caiespin/Master_Tesis_2DOF_Gimbal_Model_and_Control/README.md

# Master_Tesis_2DOF_Gimbal_Model_and_Control
Modelling and control of a two axis camera Pan-Tilt unit (gimbal)

Check results at [video](https://youtu.be/UOXjcZ1aPac)

**Simulations**

To visualize the simulation graphs:

1. Run GimbalParameters.m
2. Run each model ControlCSM.slx, ControlCSMSW.slx, ControlPI.slx and ControlSM.slx
3. Run GenerateGraphs.m

**dsPIC Implementation**

Needed MPLAB Device Blocks for Simulink

**LaTex Document**

Thesis Document
