caiespin/Master_Tesis_2DOF_Gimbal_Model_and_Control/LaTex_Doc/includes/portada1.tex

\thispagestyle{empty}
\begin{minipage}{0.15\textwidth}

\end{minipage}
\begin{minipage}{0.87\textwidth}
\begin{center}
\sc CENTRO DE INVESTIGACI\'{O}N Y DE ESTUDIOS \\ AVANZADOS DEL INSTITUTO POLIT\'{E}CNICO NACIONAL
\end{center}
\end{minipage}
\begin{minipage}{1\textwidth}
\vspace{0.2cm}
\centerline{\Large \bf Unidad Zacatenco}
\vspace{0.25cm}
\centerline{\bf Programa de}
\vspace{0.20cm}
\centerline{\large \bf Sistemas Aut\'onomos de Navegaci\'on A\'erea y Submarina}
\vspace{0.8cm}
\centerline{\Large \bf "Dise\~no e Implementaci\'on del Control }
\vspace{0.5cm}
\centerline{\Large \bf de un Gimbal de Dos Grados de Libertad"}
\vspace{0.8cm}
\centerline{\Large \bf TESIS}
\vspace{0.5cm}
\centerline{\bf Que presenta}
\vspace{0.4cm}
\centerline{\Large \bf Carlos Isaac Espinosa Ram\'irez}
\vspace{0.4cm}
\centerline{\bf Para obtener el grado de }
\vspace{0.4cm}
\centerline{\Large \bf Maestro en Ciencias}
\vspace{0.4cm}
\centerline{\bf En}
\vspace{0.4cm}
\centerline{\Large \bf Sistemas Aut\'onomos de Navegaci\'on A\'erea y Submarina}
\vspace{0.6cm}
\centerline{\bf Director de la Tesis:}
\vspace{0.20cm}
\centerline{\Large \bf Dr. Rogelio Lozano Leal}

\vspace{0.6cm}
{\large \bf M\'{e}xico, D.F.\ \hfill Enero, 2016}
\end{minipage}%
%EndExpansion

%\pagebreak
%TCIMACRO{\TeXButton{Pagina en Blanco}{\thispagestyle{empty}}}%
%BeginExpansion
\newpage
\thispagestyle{empty}%
%EndExpansion
