caiespin/Master_Tesis_2DOF_Gimbal_Model_and_Control/LaTex_Doc/img/temp/ArrMotor.docx

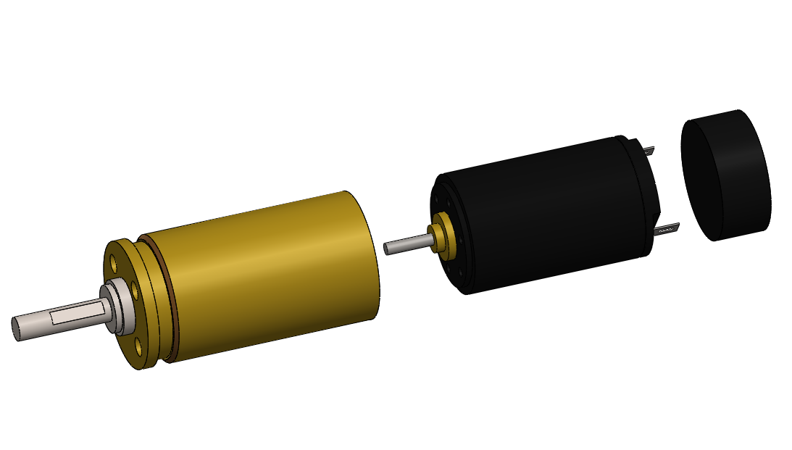
[picture p11: figure]

Encoder

Motor

Moto-reductor
