caiespin/Master_Tesis_2DOF_Gimbal_Model_and_Control/LaTex_Doc/img/temp/BaseGimbal.docx

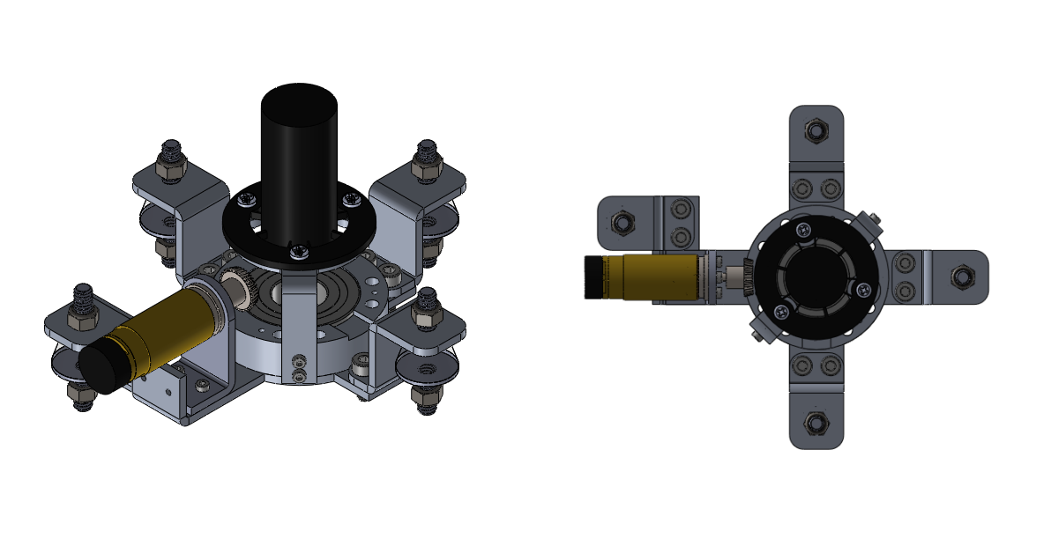
[picture p12: figure]

Piñón de

Transmisión

Motor

Balero

Slip Ring

Amortiguadores Vibratorios
