caiespin/Master_Tesis_2DOF_Gimbal_Model_and_Control/LaTex_Doc/img/temp/BaseTilt.docx

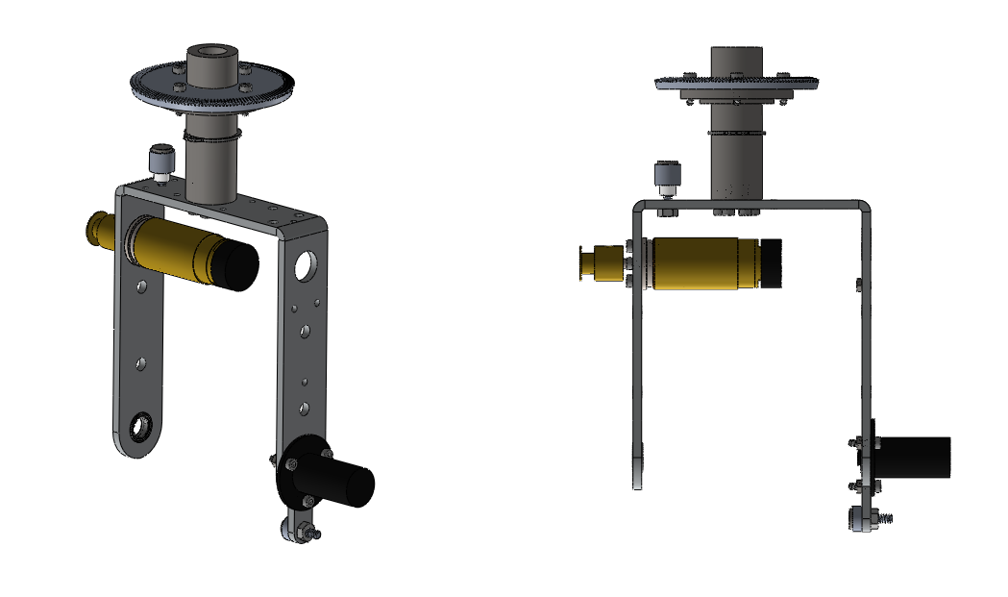
[picture p13: figure]

Polea de

Transmisión

Actuador

Magnético

Eje

Actuador

Magnético

Corona de

Transmisión

Motor

Slip Ring

Balero
