caiespin/Master_Tesis_2DOF_Gimbal_Model_and_Control/LaTex_Doc/img/temp/Gimbalclases.docx

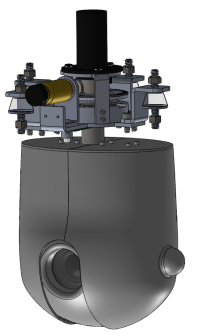
[picture p14: figure]
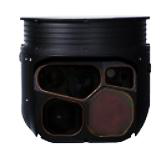
[picture p15: figure]
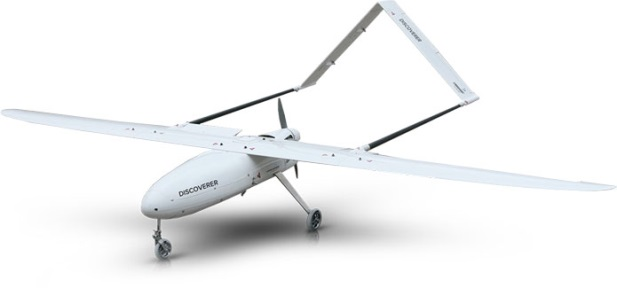
[picture p16: figure]
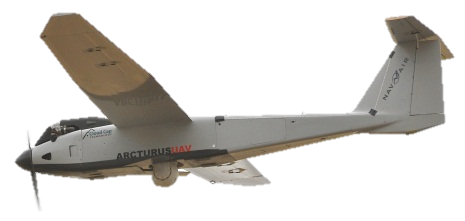
[picture p17: figure]
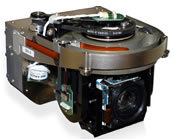
[picture p18: figure]

Plataforma de tesis

Cloud Cap: TASE 150

FLIR: Star SAFIRE 380

Cloud Cap: TASE 500

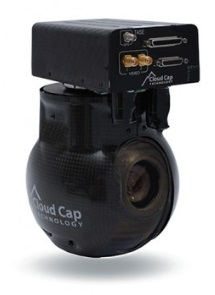
[picture p19: figure]
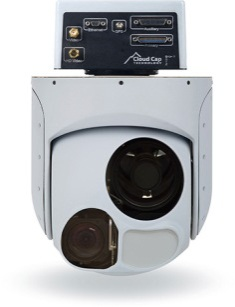
[picture p20: figure]

Cloud Cap: TASE 150

~1 kg

> 25 kg

5 kg – 10kg

< 0.5 kg

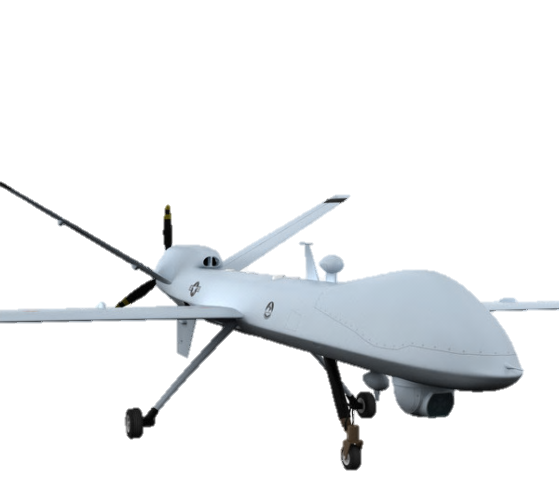
[picture p21: figure]
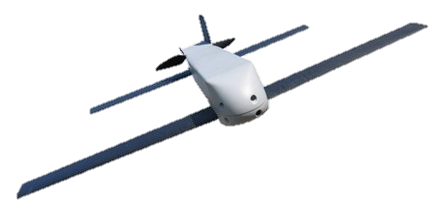
[picture p22: figure]
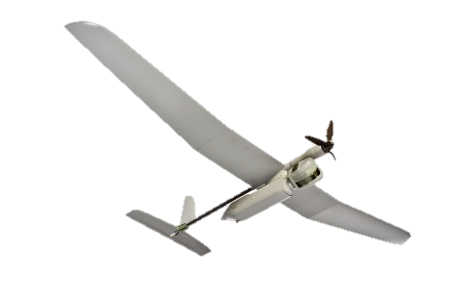
[picture p23: figure]
