caiespin/Master_Tesis_2DOF_Gimbal_Model_and_Control/LaTex_Doc/img/temp/LOSDef.docx

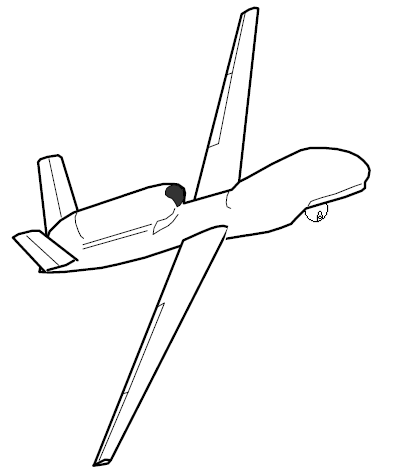
[picture p24: figure]

Error

Línea de Vista Ideal

Objetivo

Línea de Vista

Sensor

Campo de Visión (FOV)
