caiespin/Master_Tesis_2DOF_Gimbal_Model_and_Control/LaTex_Doc/img/ArrMotor.pdf

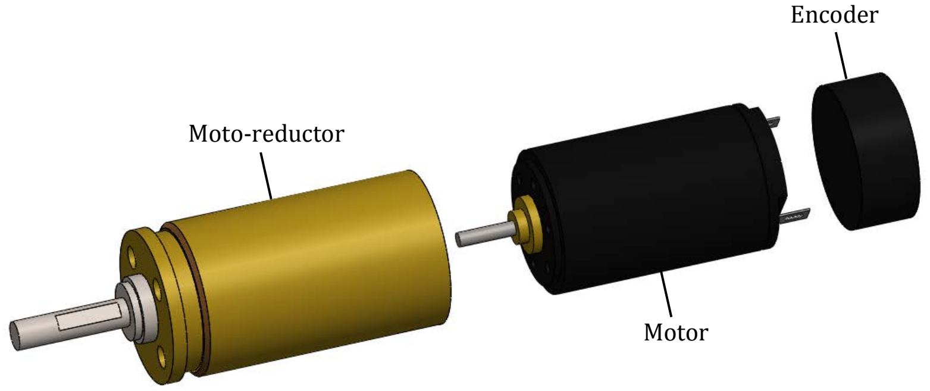
[picture p25: page 1]

Moto-reductor

Motor

Encoder
