caiespin/Master_Tesis_2DOF_Gimbal_Model_and_Control/LaTex_Doc/img/BasePan.pdf

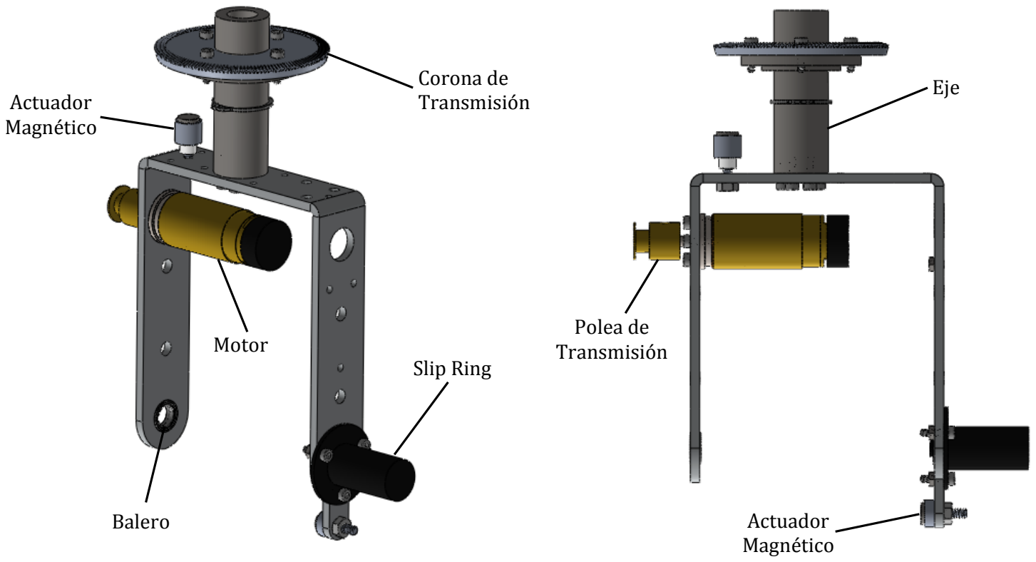
[picture p26: page 1]

Balero

Slip Ring

Motor

Corona de
Actuador Transmisión
Magnético
Polea de
Transmisión

Eje

Actuador
Magnético
