caiespin/Master_Tesis_2DOF_Gimbal_Model_and_Control/LaTex_Doc/img/Gimbalclases1.pdf

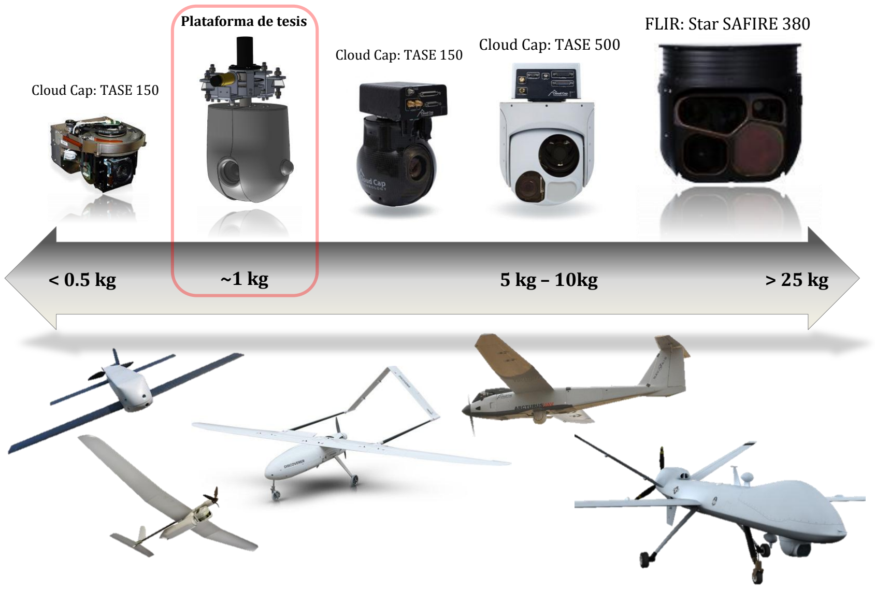
[picture p27: page 1]

### FLIR: Star SAFIRE 380

Cloud Cap: TASE 500
Cloud Cap: TASE 150

Cloud Cap: TASE 150

< 0.5 kg | 5 kg – 10kg | > 25 kg

Plataforma de tesis

~1 kg
