caiespin/Master_Tesis_2DOF_Gimbal_Model_and_Control/LaTex_Doc/img/LOSDef.pdf

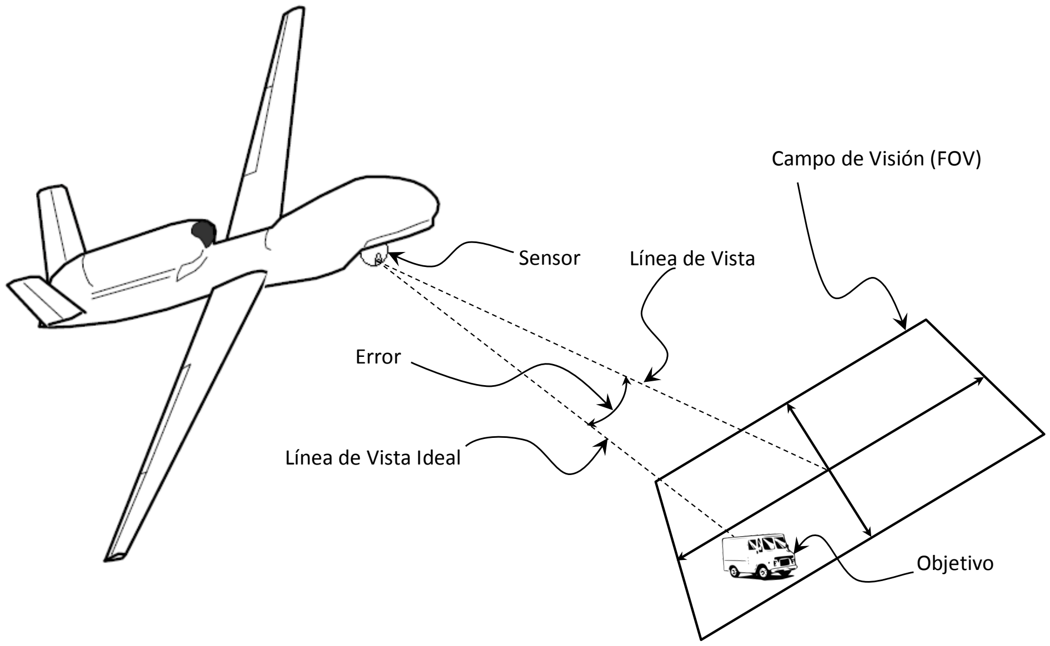
[picture p28: page 1]

Campo de Visión (FOV)

Sensor Línea de Vista

Objetivo

Línea de Vista Ideal

Error
