caiespin/Master_Tesis_2DOF_Gimbal_Model_and_Control/LaTex_Doc/includes/contents.tex

%%%%%%%%%%%%%%%%%%%%%%%%%%%%%%%%%%%%%%%%%%%%%%%%%%%%%%%%%%%%%%%%%%%%%%%%%%%%%%%%%%%%%%%%%%%%%%
% Plantilla para tesis por David Luna se encuentra bajo una Licencia
% Creative Commons Atribución-NoComercial-CompartirIgual 3.0 Unported.
% http://creativecommons.org/licenses/by-nc-sa/3.0/
%%%%%%%%%%%%%%%%%%%%%%%%%%%%%%%%%%%%%%%%%%%%%%%%%%%%%%%%%%%%%%%%%%%%%%%%%%%%%%%%%%%%%%%%%%%%%%

\cleardoublepage
\tableofcontents
\cleardoublepage
%\addcontentsline{toc}{chapter}{Lista de figuras} % para que aparezca en el indice de contenidos
\listoffigures % indice de figuras

\cleardoublepage
%\addcontentsline{toc}{chapter}{Lista de tablas} % para que aparezca en el indice de contenidos
\listoftables % indice de tablas
\newpage
$\ $
\thispagestyle{empty} % para que no se numere esta pagina
