caiespin/Master_Tesis_2DOF_Gimbal_Model_and_Control/LaTex_Doc/includes/Dedicatoria.tex

\thispagestyle{empty}
\newenvironment{dedication} {\cleardoublepage
\thispagestyle{empty}
\vspace*{\stretch{1}} \begin{center} \em} {\end{center}
\vspace*{\stretch{3}} \clearpage}
\begin{dedication}
\hfill \
\parbox{12cm}{
\begin{verse}
A mis padres,\newline
por su amor y apoyo incondicional.
\end{verse}

\begin{verse}
A mis hermanas,\newline
por su cari\~{n}o y paciencia.
\end{verse}

\begin{verse}
A mi novia,\newline
por todos los retos que superamos juntos.
\end{verse}
}
\end{dedication}

\newpage
$\ $
\thispagestyle{empty} % para que no se numere esta pagina
