caiespin/Master_Tesis_2DOF_Gimbal_Model_and_Control/LaTex_Doc/includes/publicaciones.tex

%%%%%%%%%%%%%%%%%%%%%%%%%%%%%%%%%%%%%%%%%%%%%%%%%%%%%%%%%%%%%%%%%%%%%%%%%%%%%%%%%%%%%%%%%%%%%%
% Plantilla para tesis por David Luna se encuentra bajo una Licencia
% Creative Commons Atribución-NoComercial-CompartirIgual 3.0 Unported.
% http://creativecommons.org/licenses/by-nc-sa/3.0/
%%%%%%%%%%%%%%%%%%%%%%%%%%%%%%%%%%%%%%%%%%%%%%%%%%%%%%%%%%%%%%%%%%%%%%%%%%%%%%%%%%%%%%%%%%%%%%

%\addcontentsline{toc}{chapter}{Agradecimientos}

\begin{center}
\textbf{\large AGRADECIMIENTOS}
\end{center}

\vspace{1.5cm}

Agradezco a el CONACYT por el apoyo econ\'{o}mico brindado para la realizaci\'{o}n de mis estudios de maestr\'{i}a.
\newline\newline
Agradezco al CINVESTAV y al laboratorio UMI LAFMIA por la oportunidad de realizar mis estudios de posgrado en esta intituci\'{o}n de enorme calidad.
\newline\newline
Quiero agradecerle a mi asesor, el Dr. Rogelio Lozano leal y 
\newline\newline
Agradezco a los miembros del jurado, el Dr. Sergio Rosario Salazar Cruz, el Dr. Antonio Osorio Cordero y al Dr. Mois\'{e}s Bonilla Estrada, por las valiosas contribuciones que hicieron al trabajo final y por el tiempo que dedicaron para revisarlo, a\'{u}n a pesar de las tantas actividades que los ocupan.
\newline\newline
Agradezco al INIDETAM y a su personal por el  valioso apoyo en la realizaci\'{o}n de este proyecto   y especialmente al Dr. Mariano I. Lizarraga Fernandez por su gu\'{i}a y conocimientos invaluables que me brindo para llevar a cabo esta investigaci\'{o}n.
\newline\newline
Finalmente agradezco a los excelentes profesores del programa de maestr\'{i}a que hacen posible el conocimiento en las aulas. A mis compa\~{n}eros de la generaci\'{o}n, por todos los buenos momentos que viv\'{i} con ellos.
\newline\newline

\hfill
\newpage
$\ $
\thispagestyle{empty} % para que no se numere esta pagina
