caiespin/Master_Tesis_2DOF_Gimbal_Model_and_Control/LaTex_Doc/includes/resumen.tex

%%%%%%%%%%%%%%%%%%%%%%%%%%%%%%%%%%%%%%%%%%%%%%%%%%%%%%%%%%%%%%%%%%%%%%%%%%%%%%%%%%%%%%%%%%%%%%
% Plantilla para tesis por David Luna se encuentra bajo una Licencia
% Creative Commons Atribución-NoComercial-CompartirIgual 3.0 Unported.
% http://creativecommons.org/licenses/by-nc-sa/3.0/
%%%%%%%%%%%%%%%%%%%%%%%%%%%%%%%%%%%%%%%%%%%%%%%%%%%%%%%%%%%%%%%%%%%%%%%%%%%%%%%%%%%%%%%%%%%%%%

%\addcontentsline{toc}{chapter}{Resumen}
\begin{center}
\textbf{\large RESUMEN}
\end{center}

\vspace{3cm}

Esta tesis trata sobre el modelado, control y desarrollo de una unidad de cámara Pan-Tilt (gimbal) de 2 grados de libertad el cual esta destinado a usarse en un avión no tripulado (UAV) para fines de inteligencia, vigilancia y reconocimiento. El objetivo de esta tesis es desarrollar una estructura de control que permita estabilizar el eje óptico de la cámara hacia un objetivo aislando la cámara de las perturbaciones del entorno de operación, tales como torques externos y el movimiento angular de la plataforma logrando así mantener su dirección en el espacio inercial.\\

Se desarrollan las ecuaciones de movimiento del gimbal por el método de Newton-Euler y se formulan para poder interpretar las propiedades del sistema. Con ayuda de software CAD se obtiene una aproximación de los parámetros inerciales y se realizan diferentes simulaciones. Se procede a la construcción del prototipo y la programación del micro controlador utilizado. Finalmente se realizan pruebas para la obtención y verificación de resultados.\\

\newpage
$\ $
\thispagestyle{empty} % para que no se numere esta pagina
