caiespin/Master_Tesis_2DOF_Gimbal_Model_and_Control/LaTex_Doc/img/VN100Responce.docx

Ejemplo de comando de solicitud:

$VNRRG,8*4B

Ejemplo de respuesta del VN-100:

$VNRRG,08,-114.314,+000.058,-001.773*5F
