caiespin/Master_Tesis_2DOF_Gimbal_Model_and_Control/LaTex_Doc/img/temp/BaseTilt1.docx

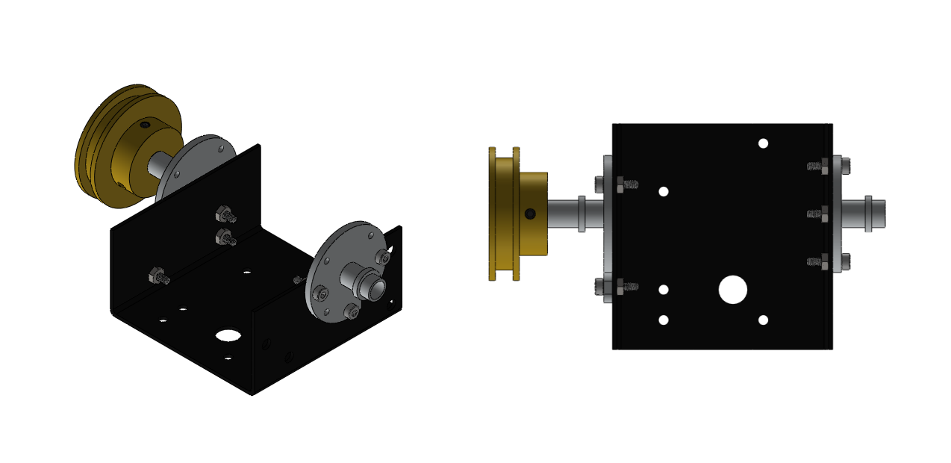
[picture p30: figure]

Polea de

Transmisión

Eje

Eje

Soporte de

la Cámara
