caiespin/Master_Tesis_2DOF_Gimbal_Model_and_Control/LaTex_Doc/img/temp/Gimbal_Frames.docx

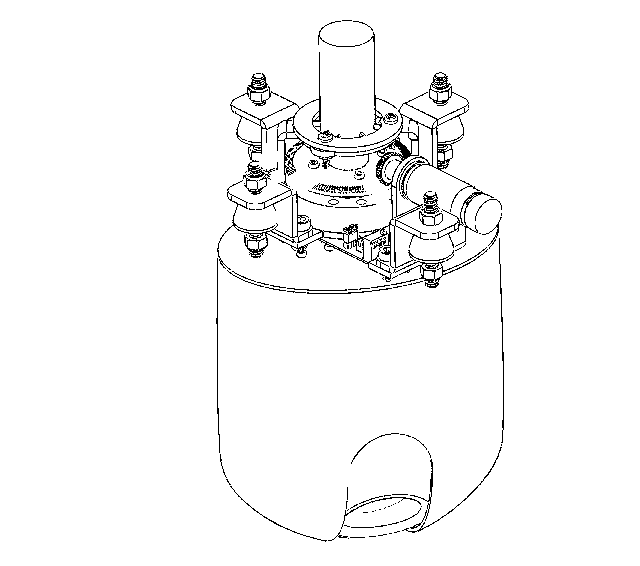
[picture p31: figure]

Marco del Eslabón Interno (T)

Eje de

Elevación cruzada

(Pan)

Eje de Elevación

(Tilt)

Marco del Cuerpo

(B)

Marco de Eslabón Externo (P)

η

i_T (Line-Of-Sight)

i_E

k_E

j_E

Marco Inercial

(E)

η

ε

j_B

ε

k_B , k_P

k_T

i_P

j_P

i_P

j_P , j_T

i_B
