caiespin/Master_Tesis_2DOF_Gimbal_Model_and_Control/LaTex_Doc/img/temp/integration.docx

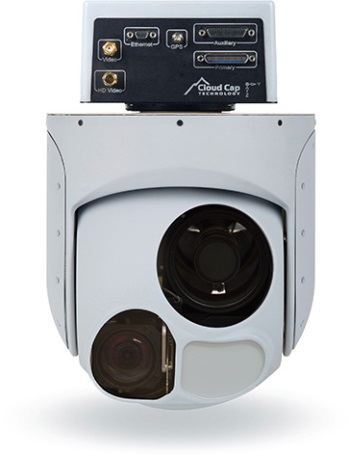
[picture p33: figure]
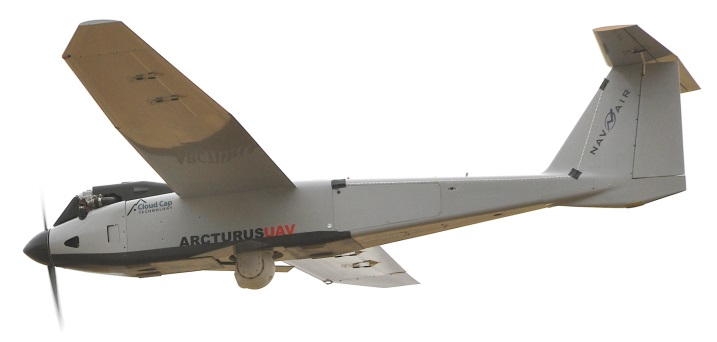
[picture p34: figure]
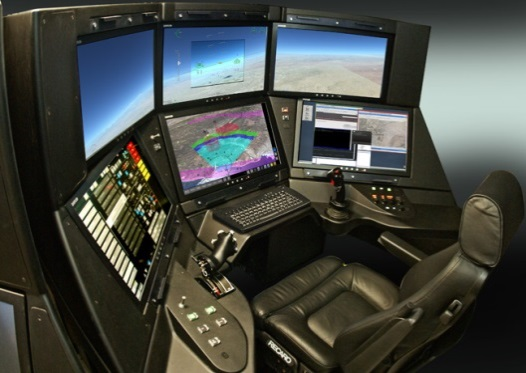
[picture p35: figure]

Plataforma Gimbal

Aviónica del vehículo

Estación de control en tierra

Conexión de

Radiofrecuencia

Bus CAN
