caiespin/Master_Tesis_2DOF_Gimbal_Model_and_Control/LaTex_Doc/img/temp/Limit.docx

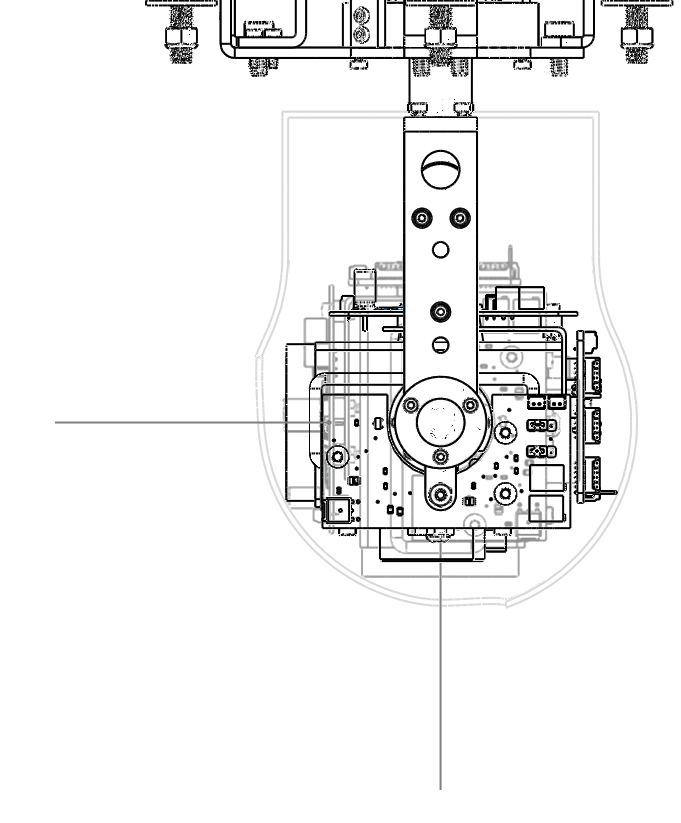
[picture p36: figure]

90°
