caiespin/Master_Tesis_2DOF_Gimbal_Model_and_Control/LaTex_Doc/img/temp/Untitled.docx

Platform Rotation Angle Example

Longitudinal Axis

North

Arbitrary Platform Orientation

Platform Aligned to North-East-Down

East

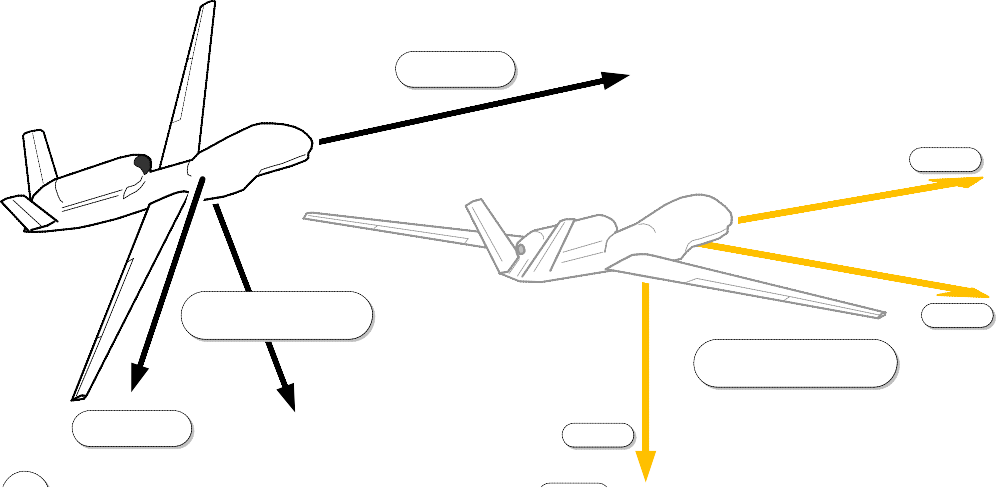
[picture p37: figure]

Transverse Axis

Down
