caiespin/Master_Tesis_2DOF_Gimbal_Model_and_Control/LaTex_Doc/img/BaseTilt.pdf

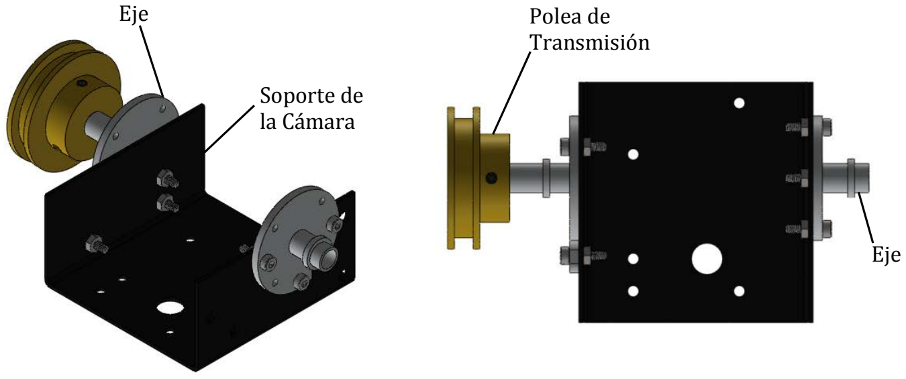
[picture p38: page 1]

Polea de
Transmisión
Soporte de la Cámara

Eje

Eje
