caiespin/Master_Tesis_2DOF_Gimbal_Model_and_Control/LaTex_Doc/img/CamaraGiroEstabilizada3-eps-converted-to.pdf

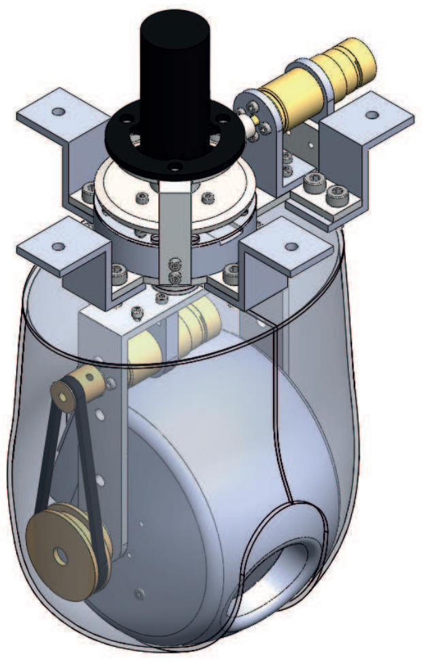
[picture p39: page 1]
