caiespin/Master_Tesis_2DOF_Gimbal_Model_and_Control/LaTex_Doc/img/document1.pdf

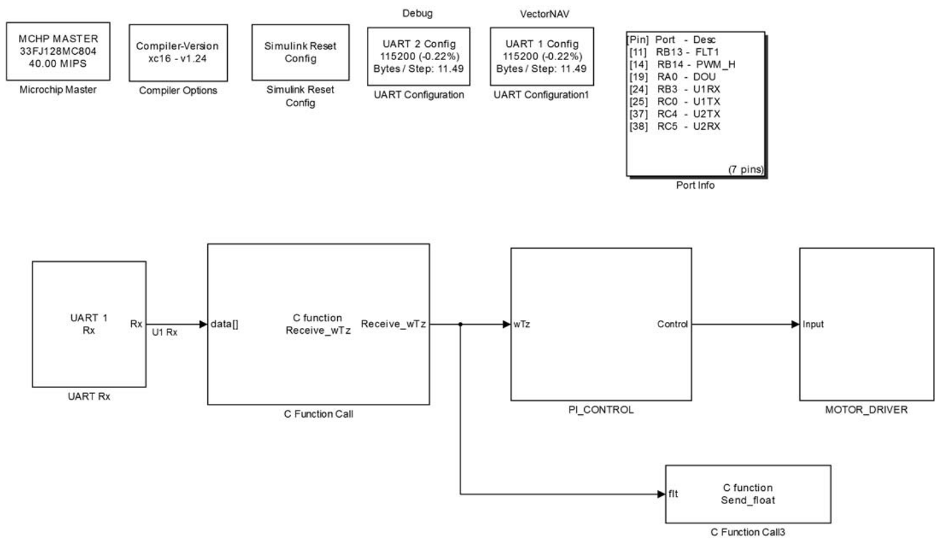
[picture p40: page 1]
