caiespin/Master_Tesis_2DOF_Gimbal_Model_and_Control/LaTex_Doc/img/Gimbalclases.pdf

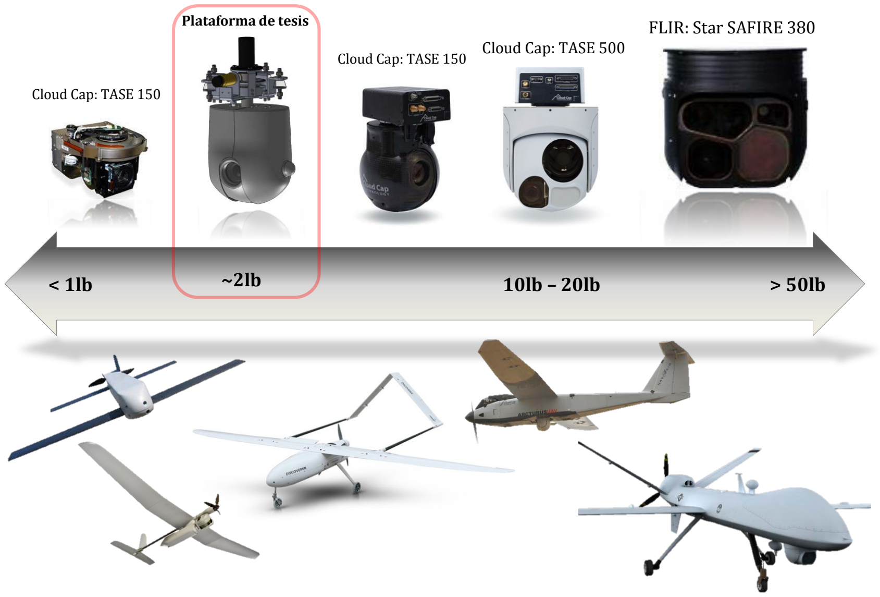
[picture p41: page 1]

FLIR: Star SAFIRE 380
Cloud Cap: TASE 500 Cloud Cap: TASE 150 Cloud Cap: TASE 150
< 1lb | 10lb – 20lb | > 50lb

Plataforma de tesis

~2lb
