caiespin/Master_Tesis_2DOF_Gimbal_Model_and_Control/LaTex_Doc/img/GimbalModelSimulink.pdf

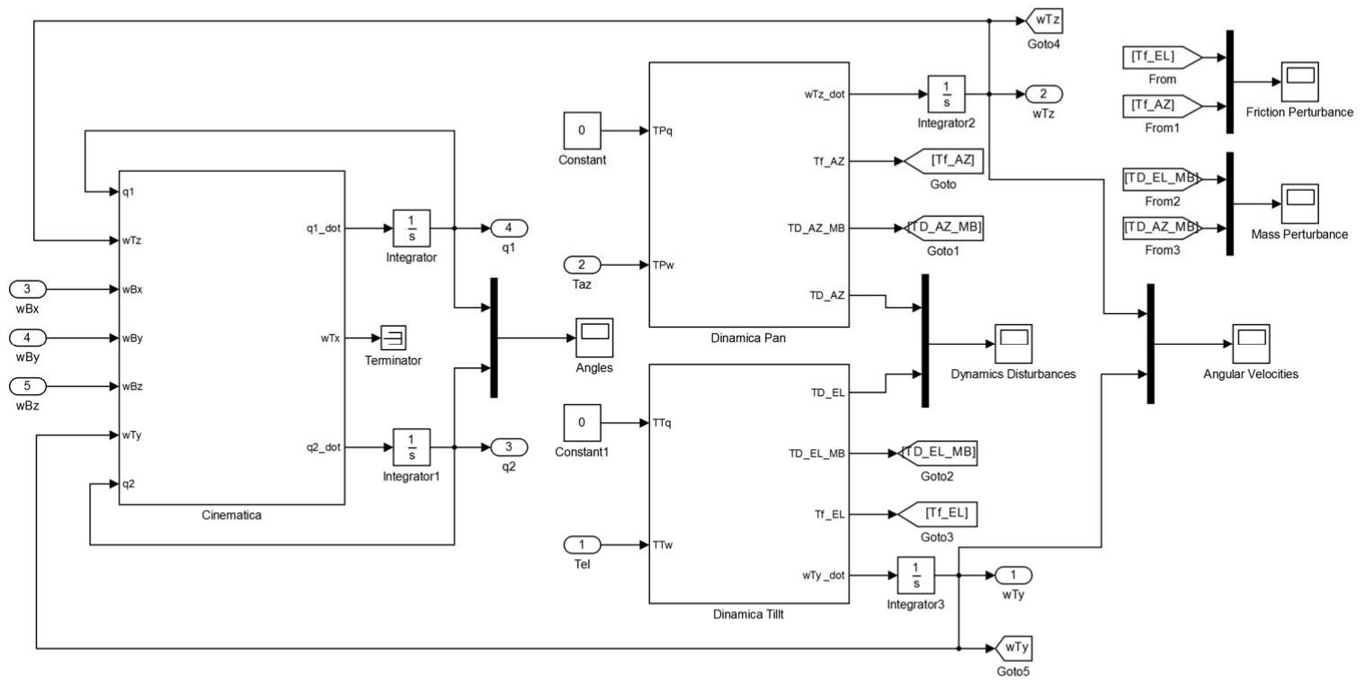
[picture p42: page 1]
