caiespin/Master_Tesis_2DOF_Gimbal_Model_and_Control/LaTex_Doc/img/HomePos.pdf

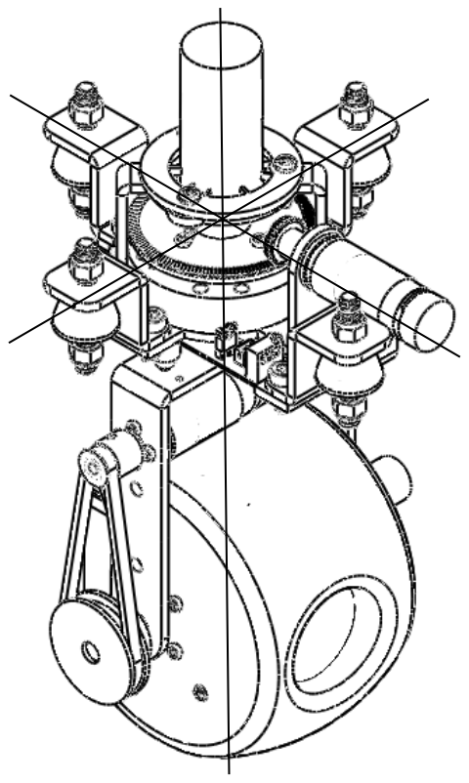
[picture p43: page 1]
