caiespin/Master_Tesis_2DOF_Gimbal_Model_and_Control/LaTex_Doc/img/integration.pdf

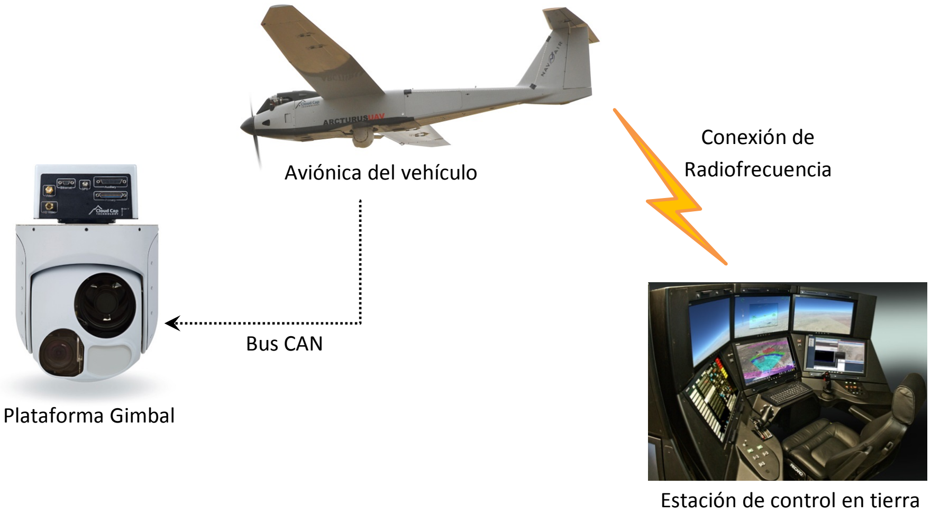
[picture p44: page 1]

Bus CAN

Conexión de
Radiofrecuencia

Estación de control en tierra

Aviónica del vehículo

Plataforma Gimbal
