caiespin/Master_Tesis_2DOF_Gimbal_Model_and_Control/LaTex_Doc/img/Limit.pdf

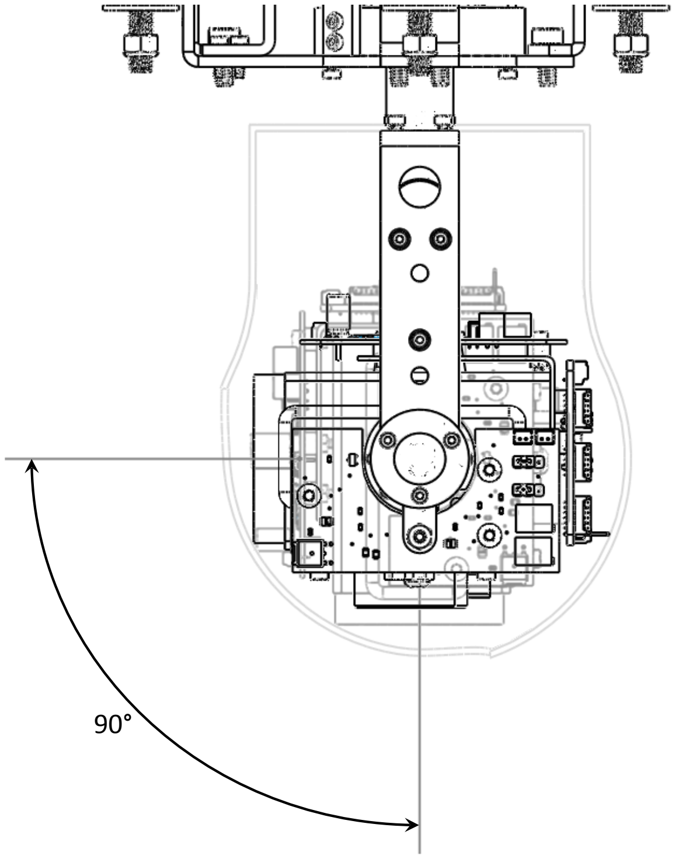
[picture p45: page 1]

90°
