caiespin/Master_Tesis_2DOF_Gimbal_Model_and_Control/LaTex_Doc/img/Prog.pdf

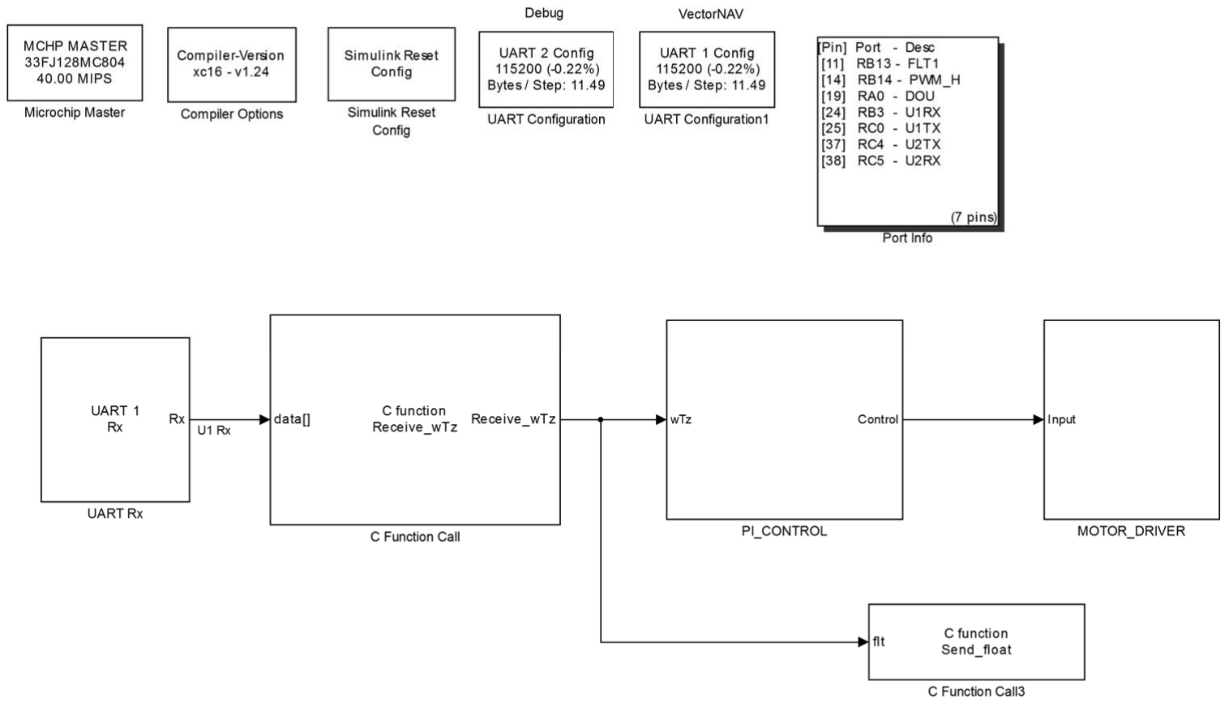
[picture p46: page 1]
