caiespin/Master_Tesis_2DOF_Gimbal_Model_and_Control/LaTex_Doc/img/Simulink.pdf

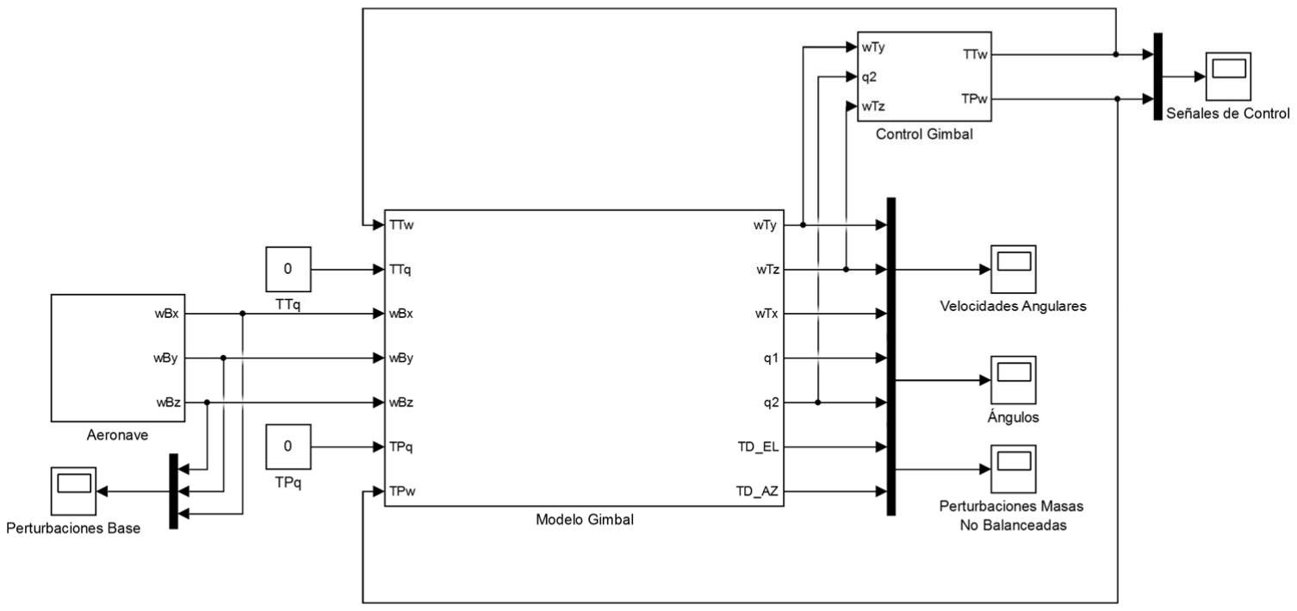
[picture p47: page 1]
