caiespin/Master_Tesis_2DOF_Gimbal_Model_and_Control/LaTex_Doc/img/15-5_P.JPG

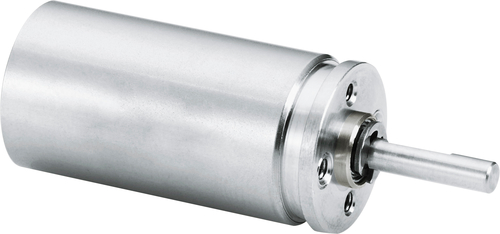
LaTex_Doc/img/15-5_P.JPG
