caiespin/Master_Tesis_2DOF_Gimbal_Model_and_Control/LaTex_Doc/img/GimbalLimit.PNG

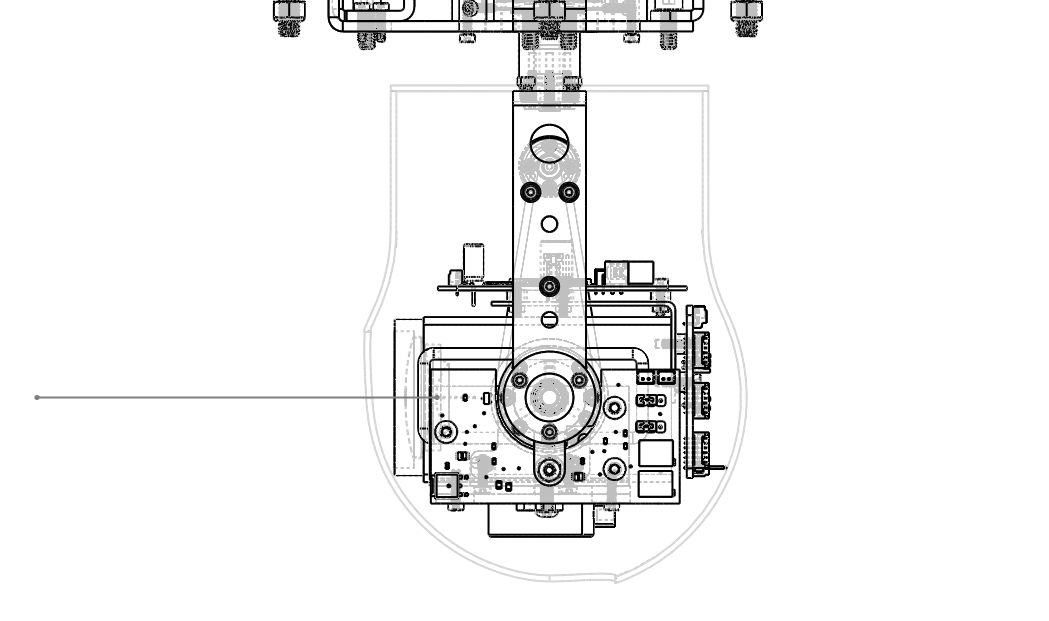
LaTex_Doc/img/GimbalLimit.PNG
