caiespin/Master_Tesis_2DOF_Gimbal_Model_and_Control/LaTex_Doc/img/temp/635797445127078483-MQ9-Reaper.JPG

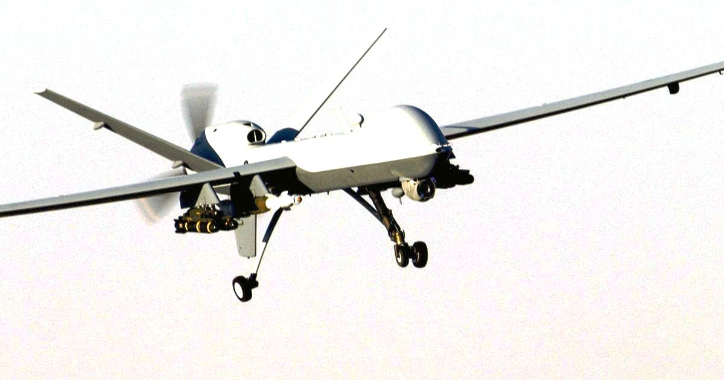
LaTex_Doc/img/temp/635797445127078483-MQ9-Reaper.JPG
