caiespin/Master_Tesis_2DOF_Gimbal_Model_and_Control/LaTex_Doc/img/temp/AIR_UAV_Skylark-ILE_Block_2_Elbit_lg.jpg

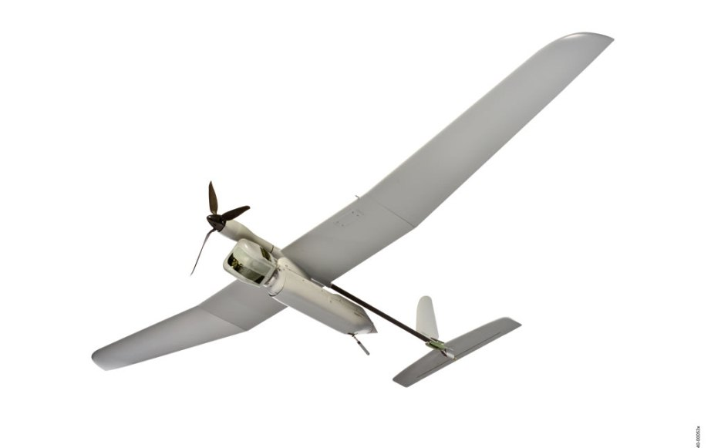
LaTex_Doc/img/temp/AIR_UAV_Skylark-ILE_Block_2_Elbit_lg.jpg
