caiespin/Master_Tesis_2DOF_Gimbal_Model_and_Control/LaTex_Doc/img/temp/design/GimbalBase1.PNG

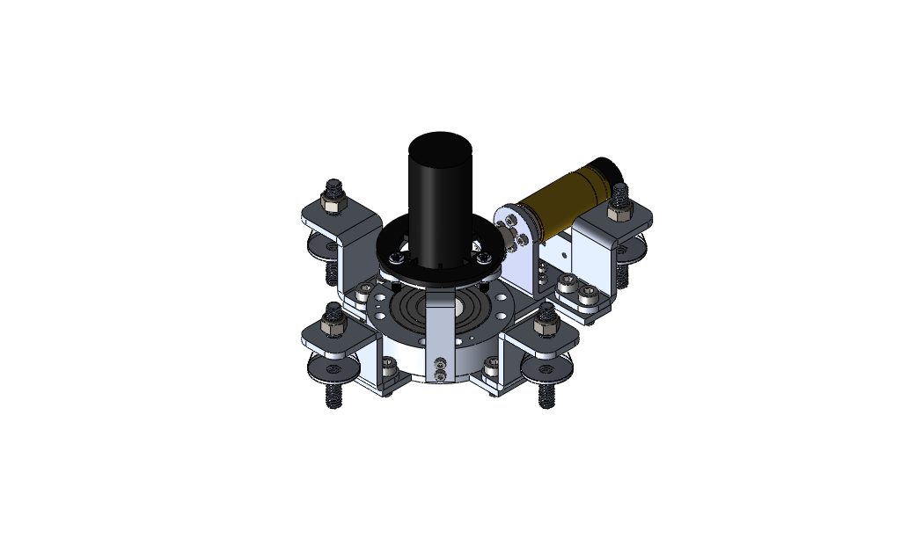
LaTex_Doc/img/temp/design/GimbalBase1.PNG
