caiespin/Master_Tesis_2DOF_Gimbal_Model_and_Control/LaTex_Doc/img/temp/gimbal_tase_lt_rev-250x250.jpg

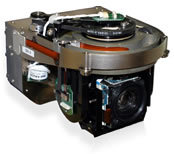
LaTex_Doc/img/temp/gimbal_tase_lt_rev-250x250.jpg
