caiespin/Master_Tesis_2DOF_Gimbal_Model_and_Control/LaTex_Doc/img/temp/MQ_9_Reaper_V2_08.jpg51b3aa70-9075-4628-b7ff-b451863145acLarge.jpg

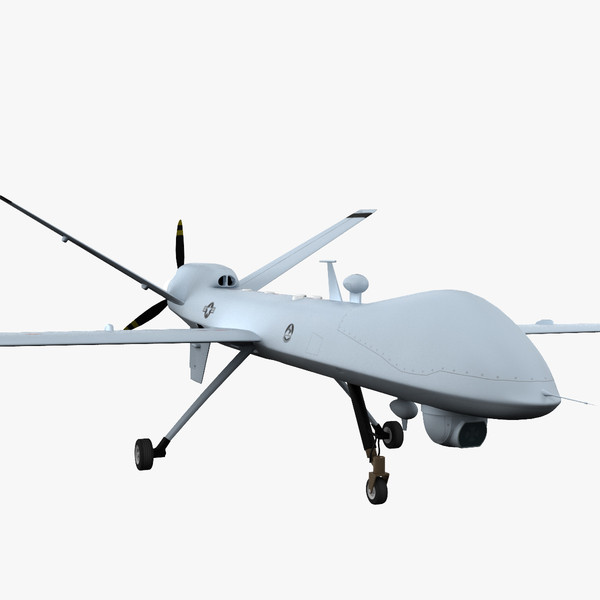
LaTex_Doc/img/temp/MQ_9_Reaper_V2_08.jpg51b3aa70-9075-4628-b7ff-b451863145acLarge.jpg
