caiespin/Master_Tesis_2DOF_Gimbal_Model_and_Control/LaTex_Doc/img/temp/puma_ae_civil.jpg

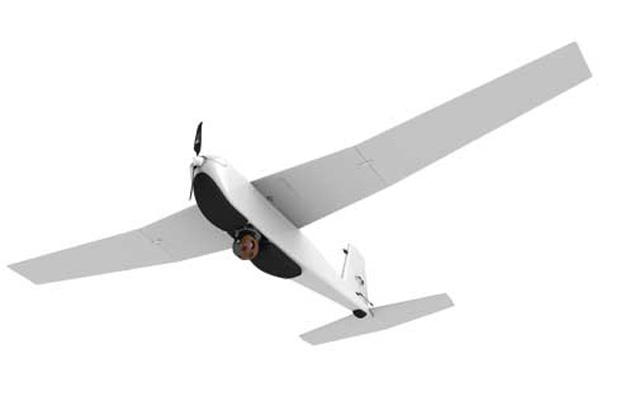
LaTex_Doc/img/temp/puma_ae_civil.jpg
