caiespin/Master_Tesis_2DOF_Gimbal_Model_and_Control/LaTex_Doc/img/temp/shark1.jpg

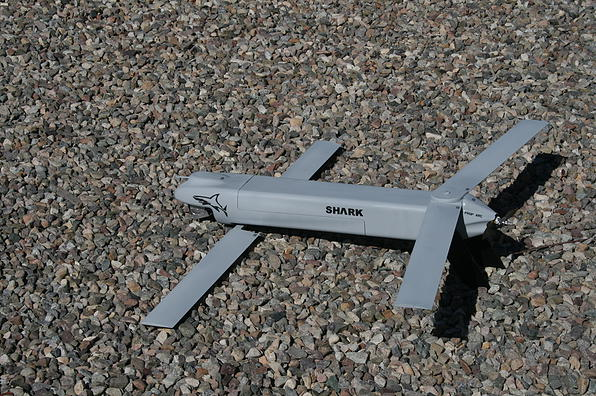
LaTex_Doc/img/temp/shark1.jpg
