caiespin/Master_Tesis_2DOF_Gimbal_Model_and_Control/LaTex_Doc/img/temp/TASE500-360-animation-01.png

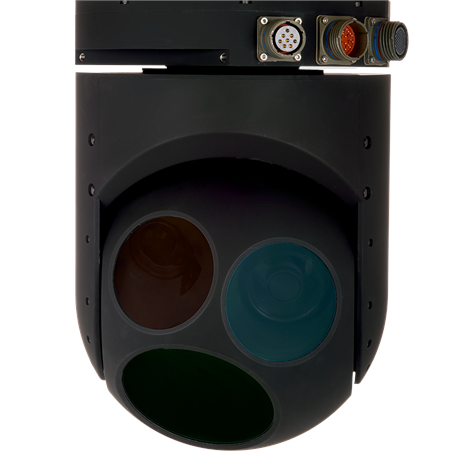
LaTex_Doc/img/temp/TASE500-360-animation-01.png
