caiespin/Master_Tesis_2DOF_Gimbal_Model_and_Control/LaTex_Doc/img/TransmisionPan.jpg

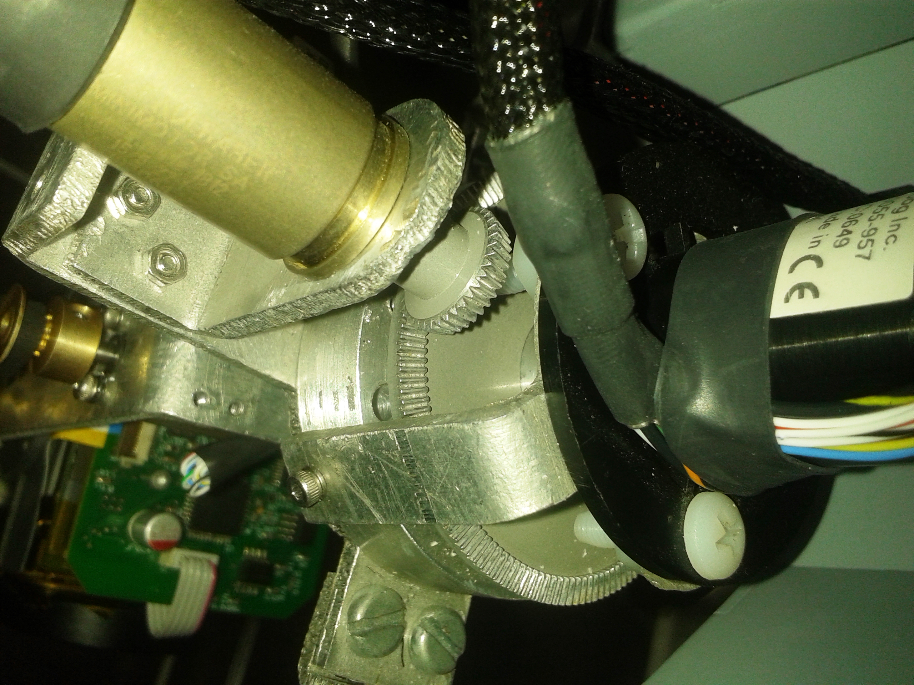
LaTex_Doc/img/TransmisionPan.jpg
