caiespin/Master_Tesis_2DOF_Gimbal_Model_and_Control/LaTex_Doc/img/temp/GimbalParts.docx

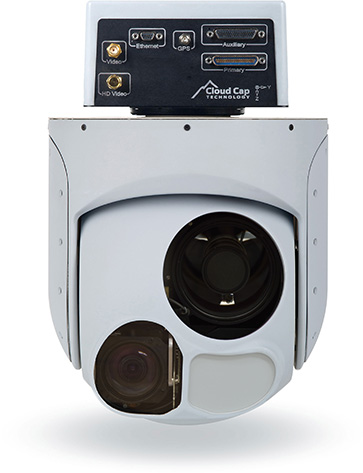
[picture p91: figure]

Base o Montaje

Eslabón externo

(Pan)

Eslabón interno (Tilt)
