caiespin/Master_Tesis_2DOF_Gimbal_Model_and_Control/LaTex_Doc/img/BasePerturbance-eps-converted-to.pdf

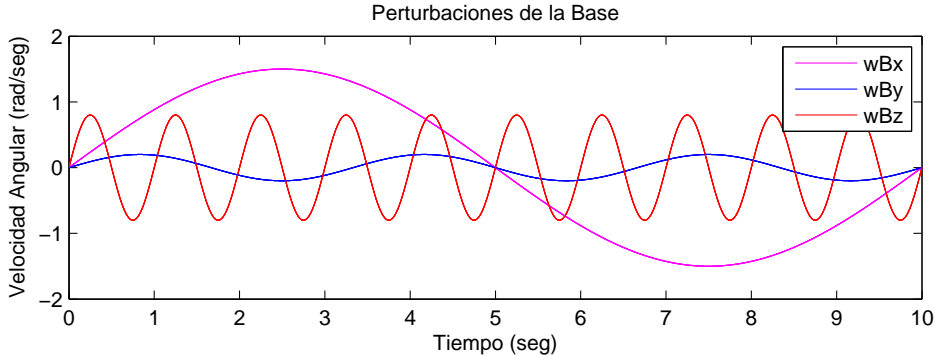
[picture p92: page 1]
Tiempo (seg); wBx wBy wBz

Perturbaciones de la Base

Velocidad Angular (rad/seg)
