caiespin/Master_Tesis_2DOF_Gimbal_Model_and_Control/LaTex_Doc/img/ChattCont-eps-converted-to.pdf

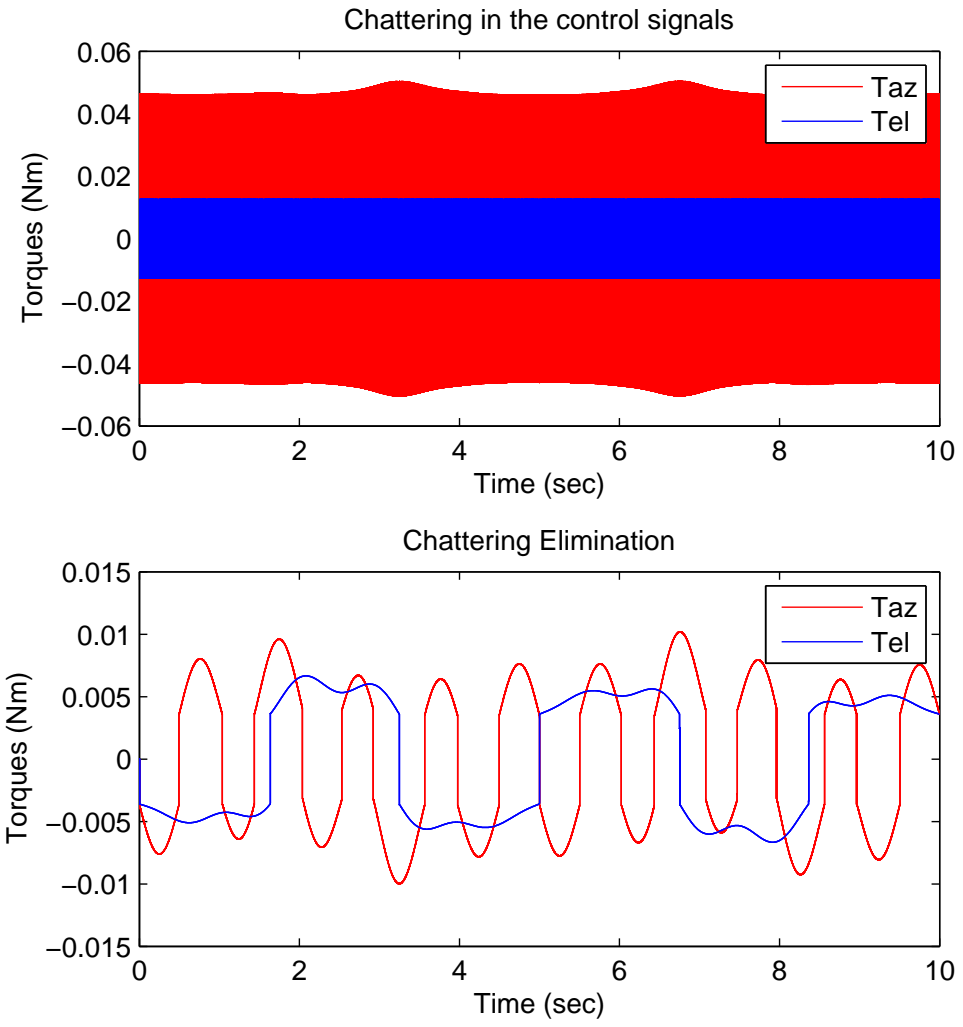
[picture p93: page 1]
Time (sec); Torques (Nm); Chattering Elimination; Taz Tel

Chattering in the control signals
