caiespin/Master_Tesis_2DOF_Gimbal_Model_and_Control/LaTex_Doc/img/ControlAction-eps-converted-to.pdf

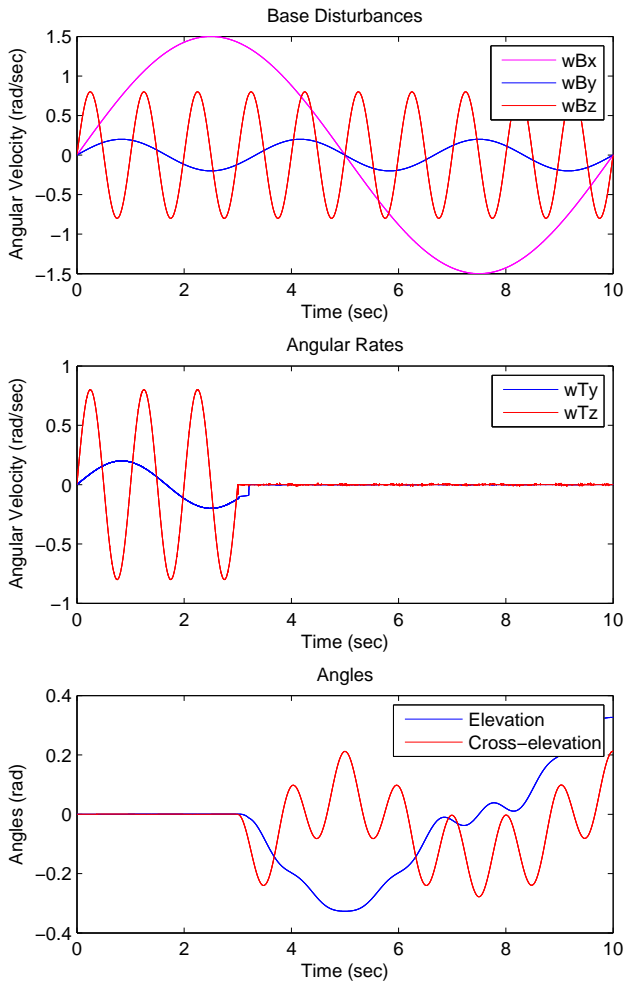
[picture p94: page 1]
Time (sec); Base Disturbances; Angular Rates; Angles (rad); Angles; wBx wBy wBz; wTy wTz; Elevation Cross−elevation

Angular Velocity (rad/sec)
