caiespin/Master_Tesis_2DOF_Gimbal_Model_and_Control/LaTex_Doc/img/ControlEffect-eps-converted-to.pdf

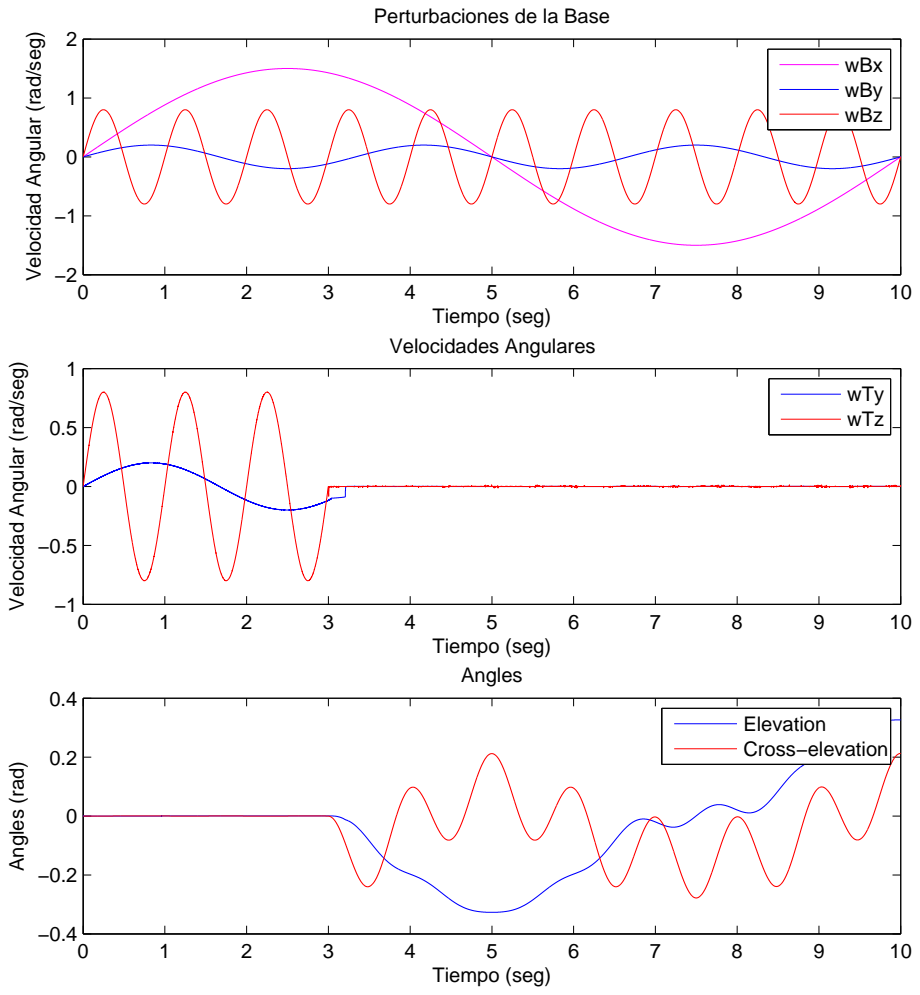
[picture p95: page 1]
Tiempo (seg); wBx wBy wBz; Velocidades Angulares; wTy wTz; Angles (rad); Angles; Elevation Cross−elevation

Perturbaciones de la Base

Velocidad Angular (rad/seg)
