caiespin/Master_Tesis_2DOF_Gimbal_Model_and_Control/LaTex_Doc/img/diagram1.pdf

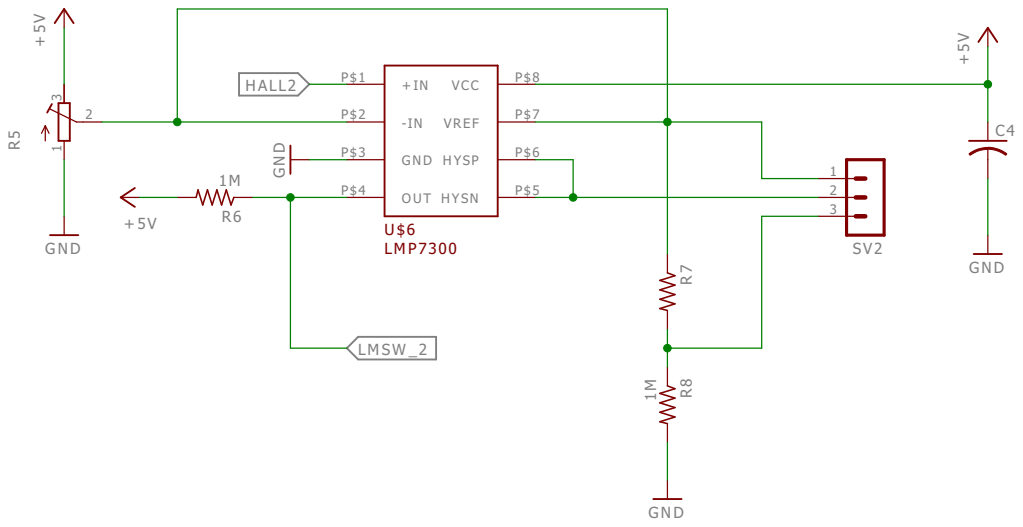
[picture p96: page 1]

GND +5V GND +5V GND 1M +5V 1M GND C4 +IN P$1 -IN P$2 GND P$3 OUT P$4 HYSN P$5 HYSP P$6 VREF P$7 VCC P$8 R5 1 3 2 R6 SV2 123 R7 R8 LMSW _2 HALL2 U$6 LMP7300
