caiespin/Master_Tesis_2DOF_Gimbal_Model_and_Control/LaTex_Doc/img/ResPIPer-eps-converted-to.pdf

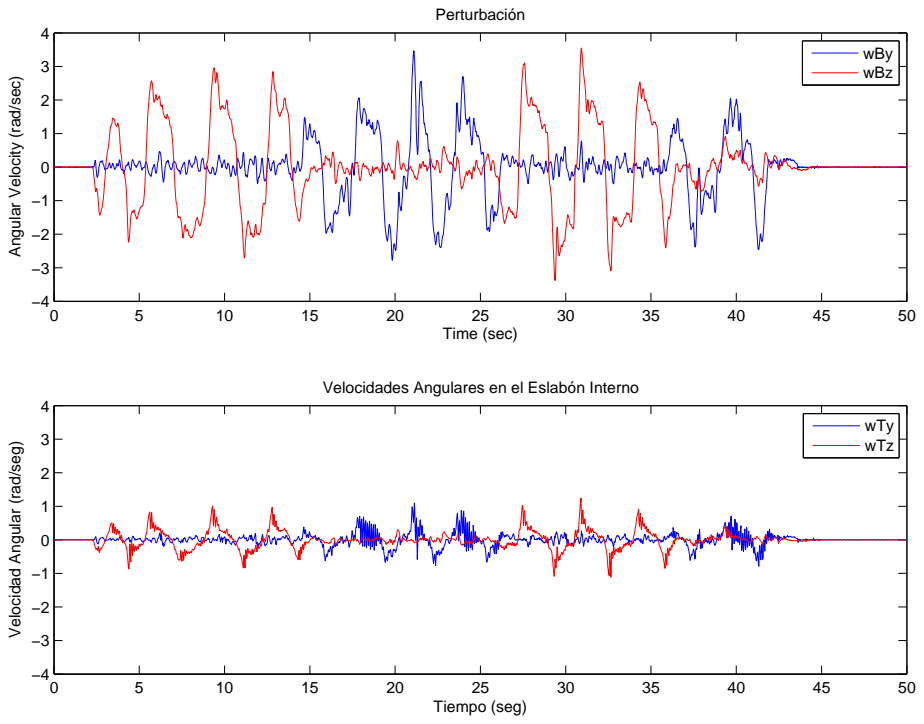
[picture p97: page 1]
Time (sec); Perturbación; wBy wBz; Tiempo (seg); wTy wTz

Angular Velocity (rad/sec)

Velocidades Angulares en el Eslabón Interno

Velocidad Angular (rad/seg)
