caiespin/Master_Tesis_2DOF_Gimbal_Model_and_Control/LaTex_Doc/img/ResPIVs-eps-converted-to.pdf

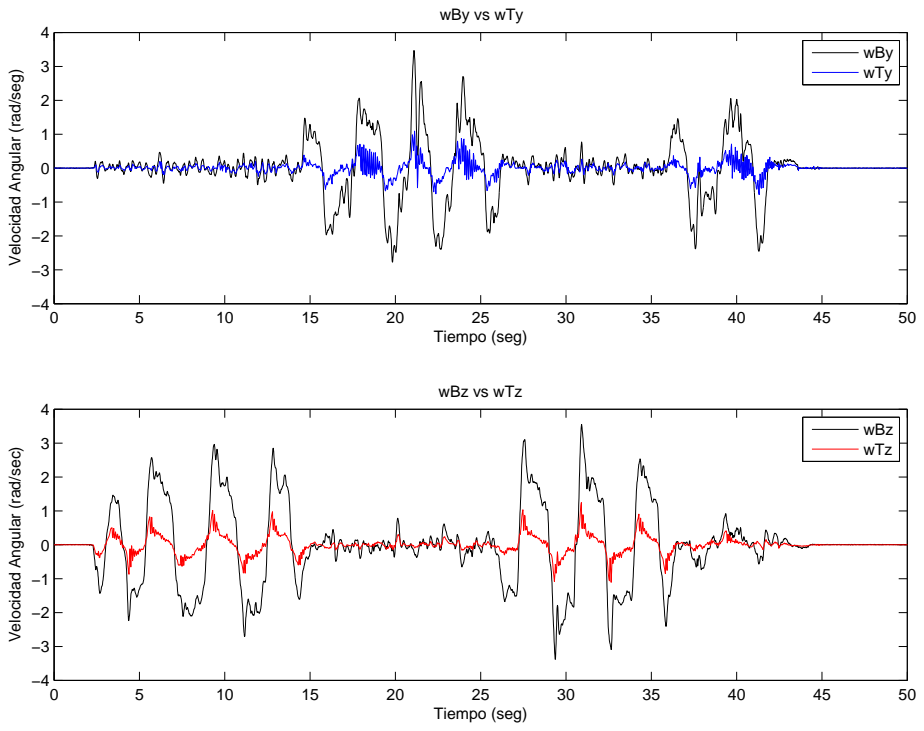
[picture p98: page 1]
Tiempo (seg); wBy wTy; wBz wTz

wBy vs wTy

Velocidad Angular (rad/seg)

wBz vs wTz

Velocidad Angular (rad/sec)
