caiespin/Master_Tesis_2DOF_Gimbal_Model_and_Control/LaTex_Doc/img/ResSMPer-eps-converted-to.pdf

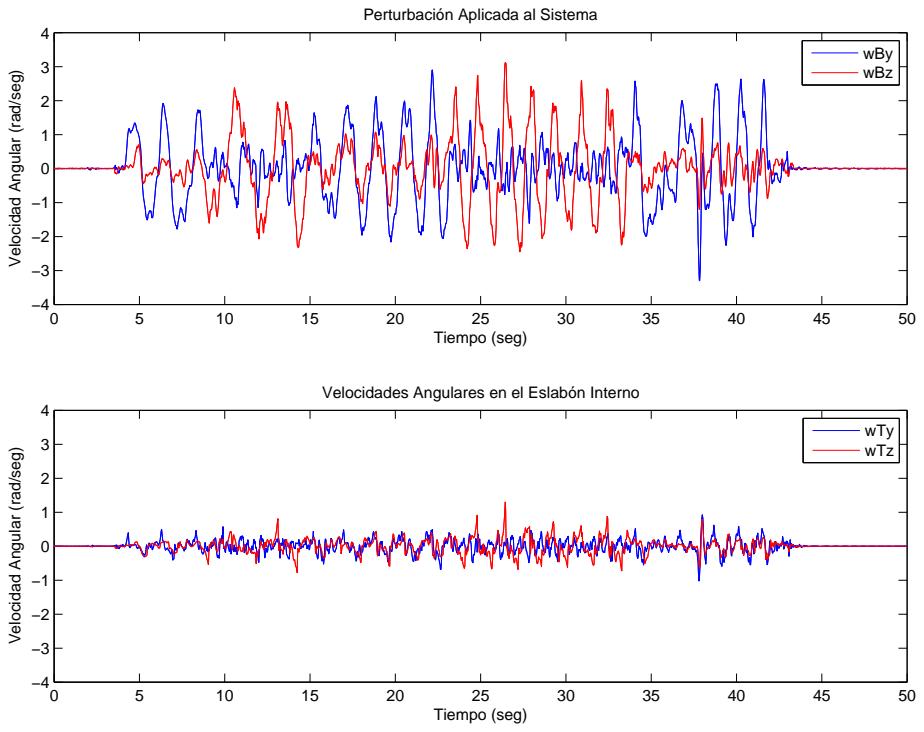
[picture p99: page 1]
Tiempo (seg); wBy wBz; wTy wTz

Perturbación Aplicada al Sistema

Velocidad Angular (rad/seg)

Velocidades Angulares en el Eslabón Interno
