caiespin/Master_Tesis_2DOF_Gimbal_Model_and_Control/LaTex_Doc/img/SMvsPICON-eps-converted-to.pdf

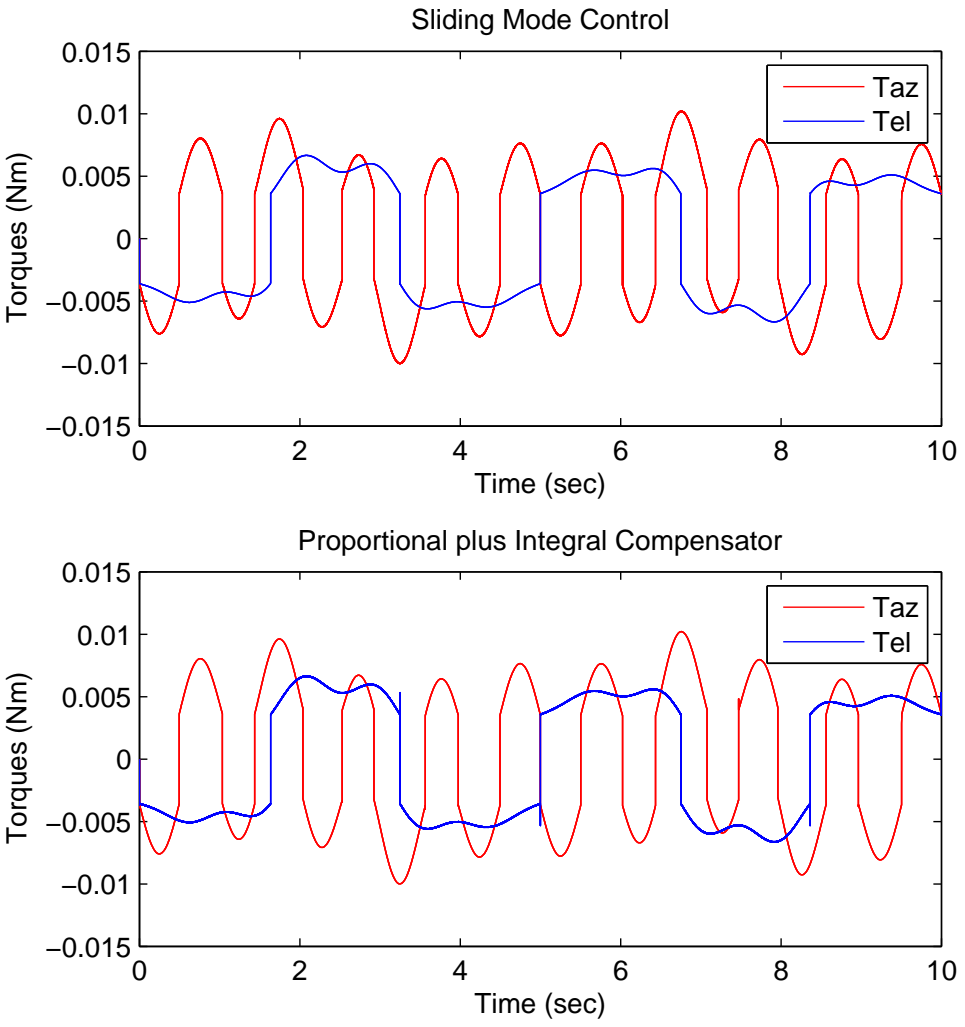
[picture p100: page 1]
Time (sec); Torques (Nm); Taz Tel

Sliding Mode Control

Proportional plus Integral Compensator
