caiespin/Master_Tesis_2DOF_Gimbal_Model_and_Control/LaTex_Doc/img/SMvsPIVEL-eps-converted-to.pdf

−0.50

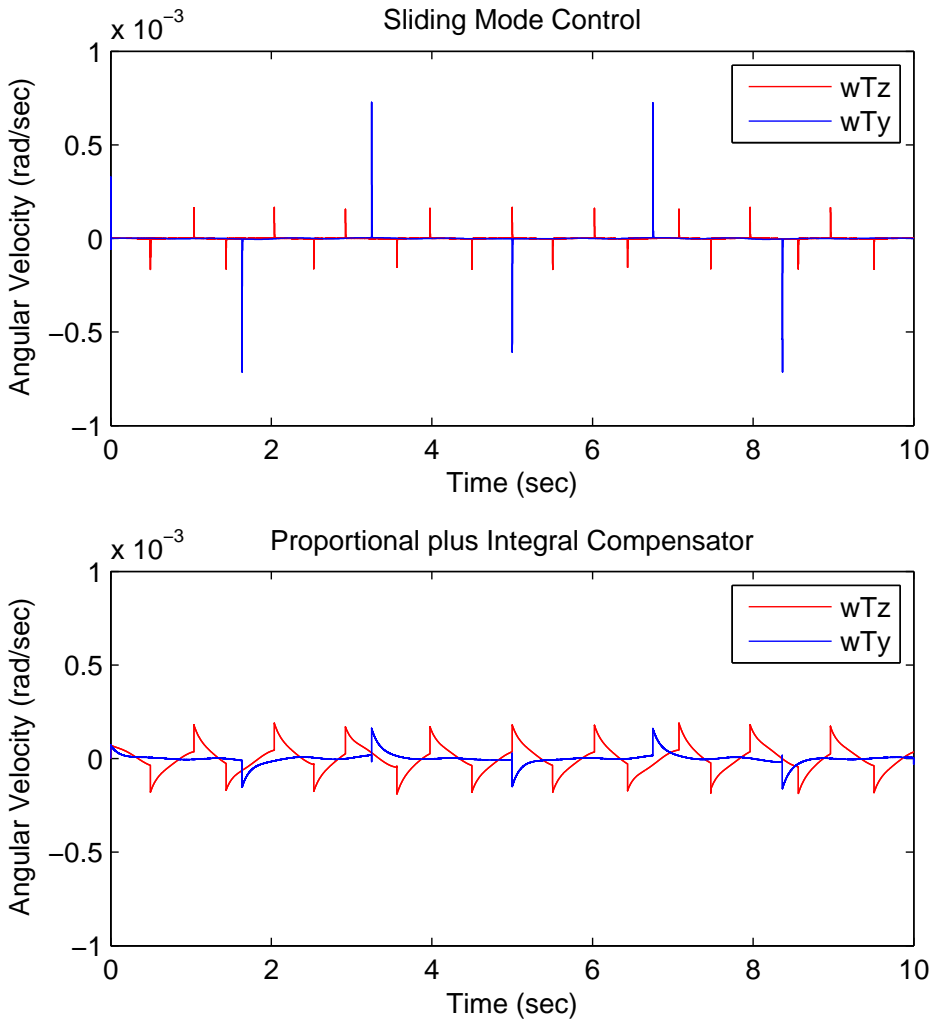
[picture p101: page 1]
Time (sec); wTz wTy

Sliding Mode Control

Angular Velocity (rad/sec)

Proportional plus Integral Compensator
