caiespin/Master_Tesis_2DOF_Gimbal_Model_and_Control/LaTex_Doc/img/VelAngular-eps-converted-to.pdf

−0.50

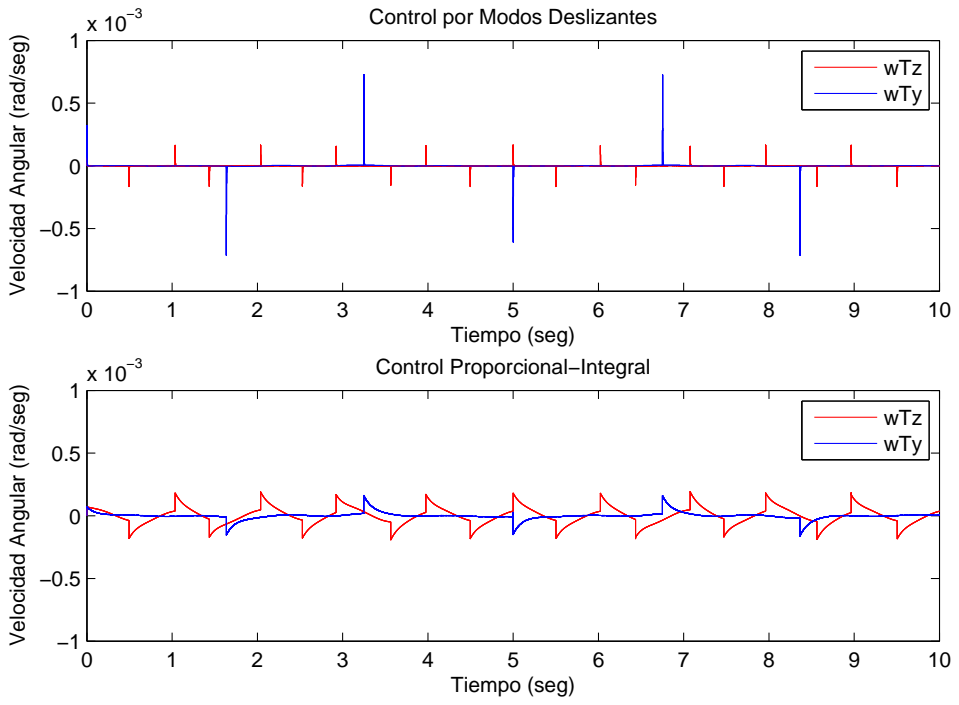
[picture p102: page 1]
Tiempo (seg); wTz wTy

Control por Modos Deslizantes

Velocidad Angular (rad/seg)

Control Proporcional−Integral
