caiespin/Master_Tesis_2DOF_Gimbal_Model_and_Control/LaTex_Doc/img/GimbalParts.pdf

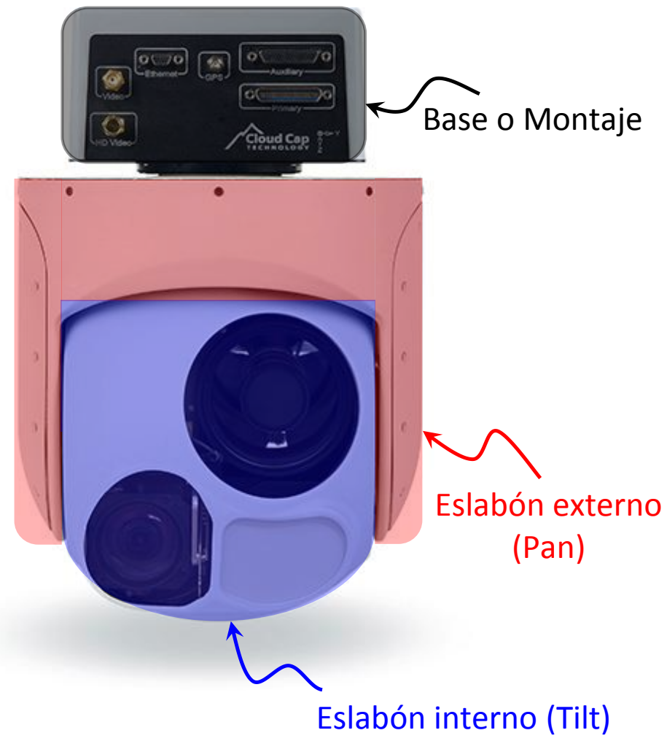
[picture p104: page 1]
Base o Montaje; Eslabón externo (Pan)

Eslabón interno (Tilt)
