caiespin/Master_Tesis_2DOF_Gimbal_Model_and_Control/LaTex_Doc/img/ChatteringRed-eps-converted-to.pdf

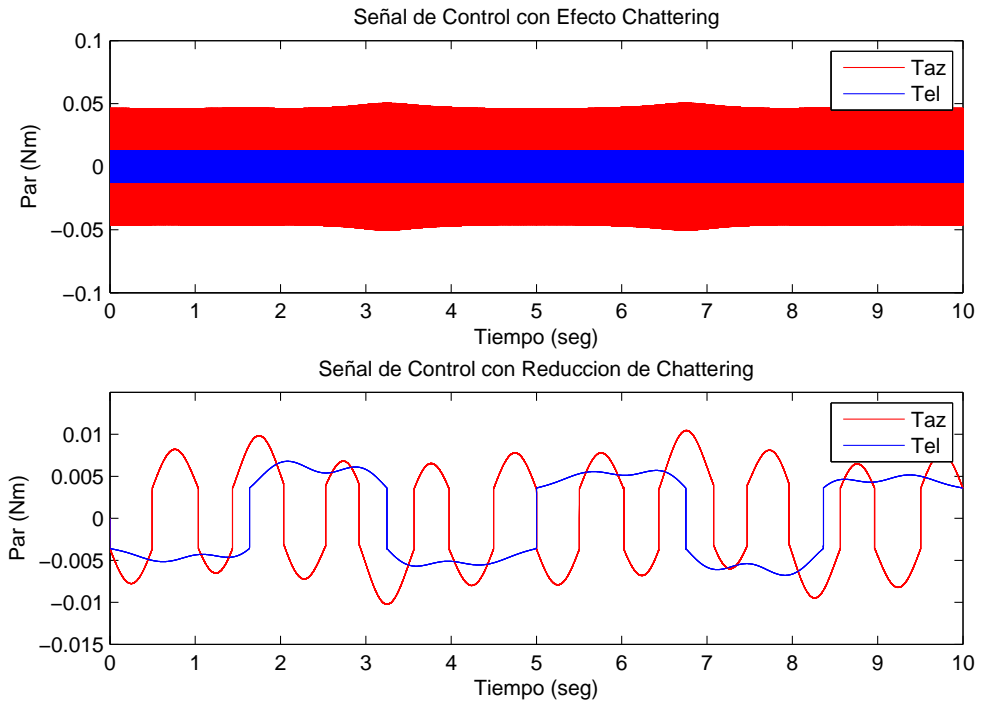
[picture p105: page 1]
Tiempo (seg); Par (Nm); Taz Tel

Señal de Control con Efecto Chattering

Señal de Control con Reduccion de Chattering
