caiespin/Master_Tesis_2DOF_Gimbal_Model_and_Control/LaTex_Doc/img/DiagControl.pdf

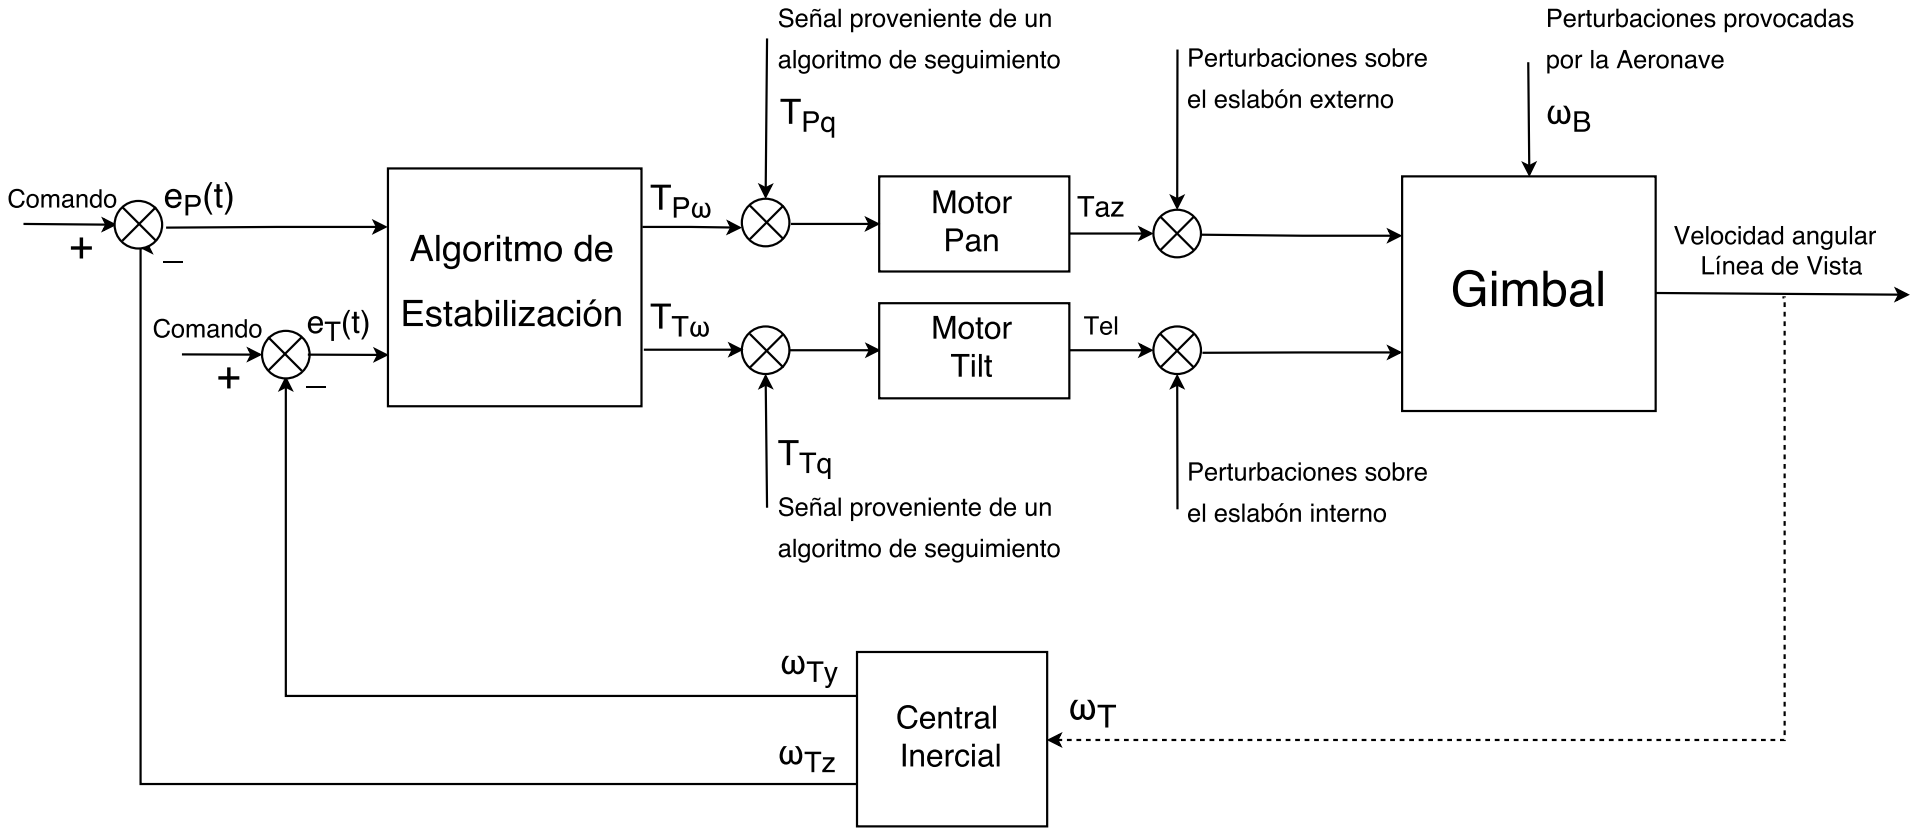
[picture p106: page 1]
