caiespin/Master_Tesis_2DOF_Gimbal_Model_and_Control/LaTex_Doc/img/Gimbal.PDF

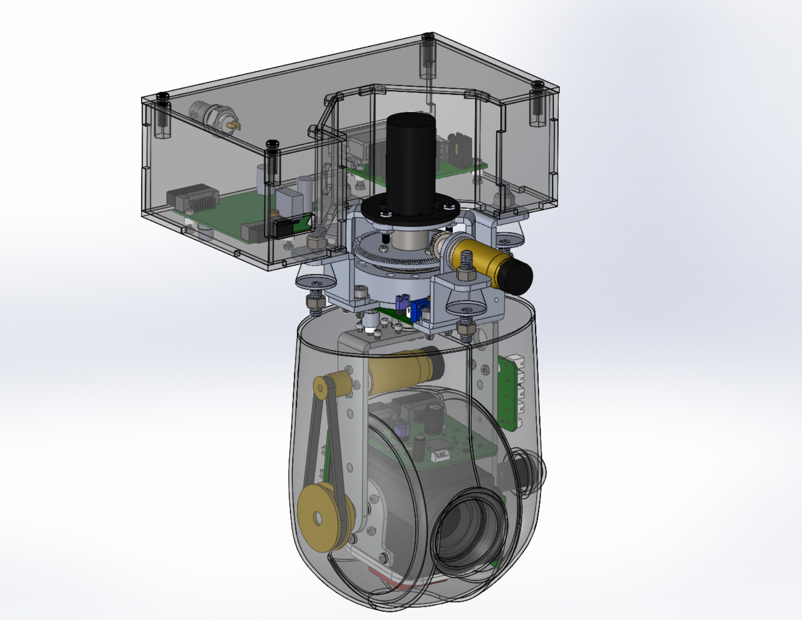
[picture p107: page 1]
