caiespin/Master_Tesis_2DOF_Gimbal_Model_and_Control/LaTex_Doc/img/Gimbal1.PDF

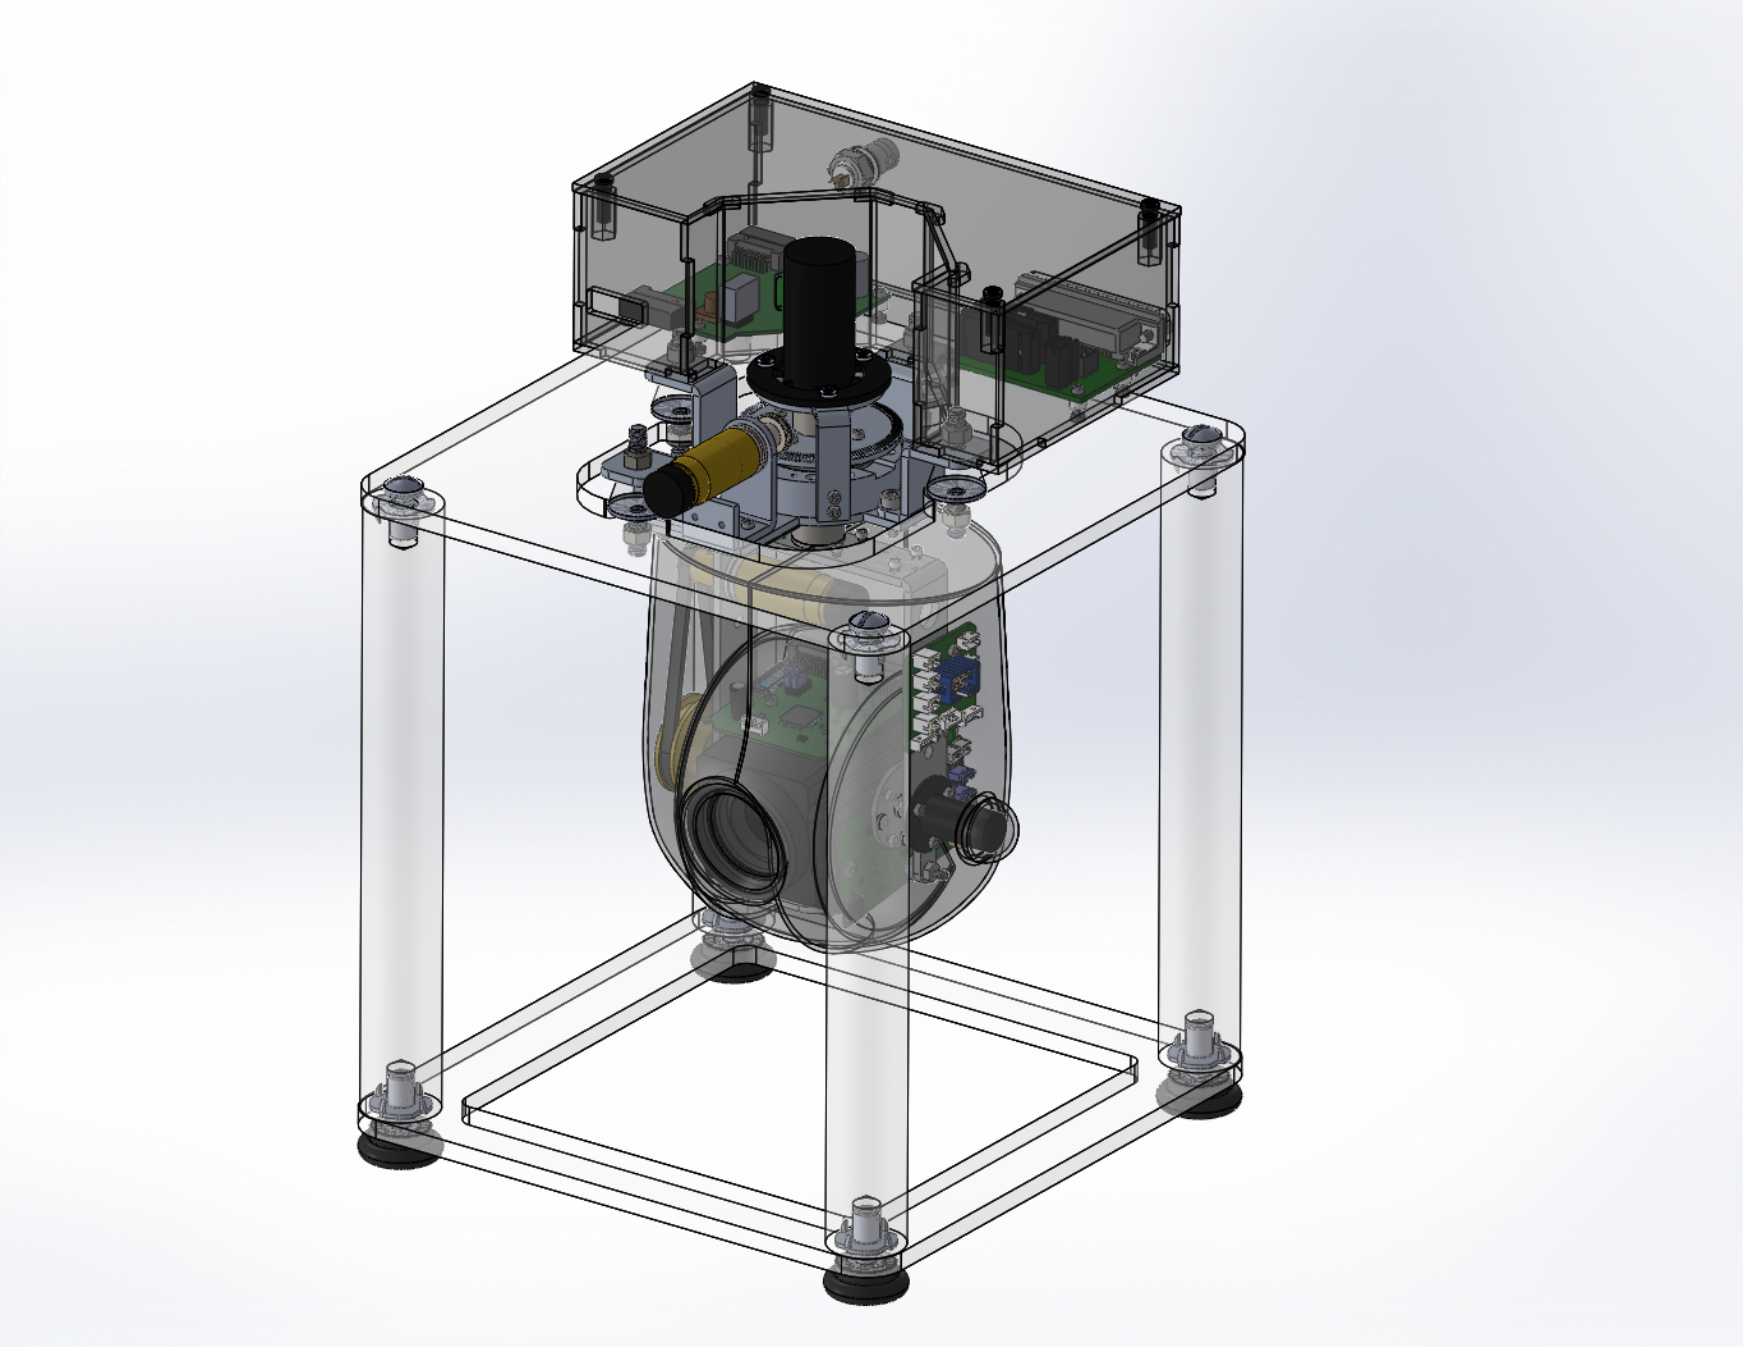
[picture p108: page 1]
