caiespin/Master_Tesis_2DOF_Gimbal_Model_and_Control/LaTex_Doc/img/LimitSW_Pan.pdf

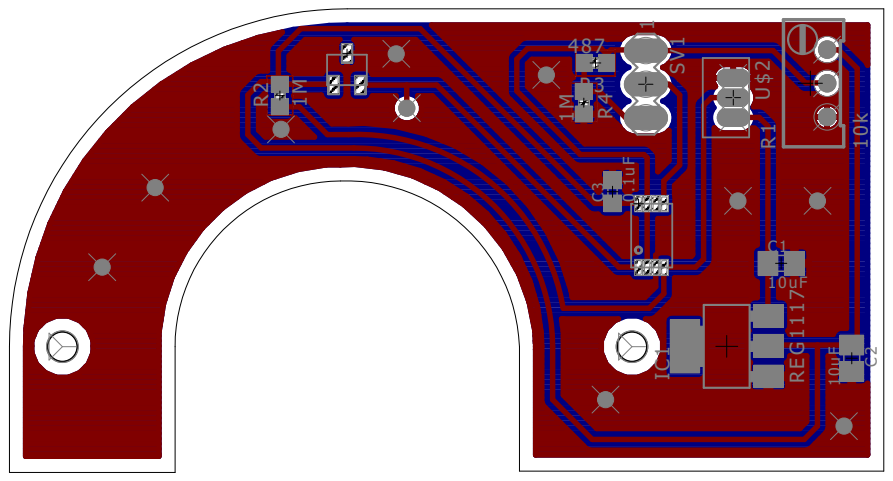
[picture p111: page 1]
