caiespin/Master_Tesis_2DOF_Gimbal_Model_and_Control/LaTex_Doc/img/LimitSW_Tilt_DW_UP.pdf

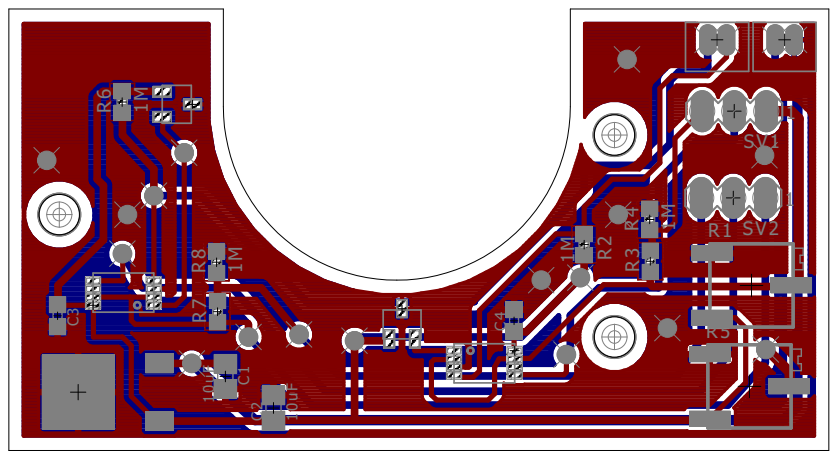
[picture p112: page 1]
