caiespin/Master_Tesis_2DOF_Gimbal_Model_and_Control/LaTex_Doc/img/LimitSWEsquematico.pdf

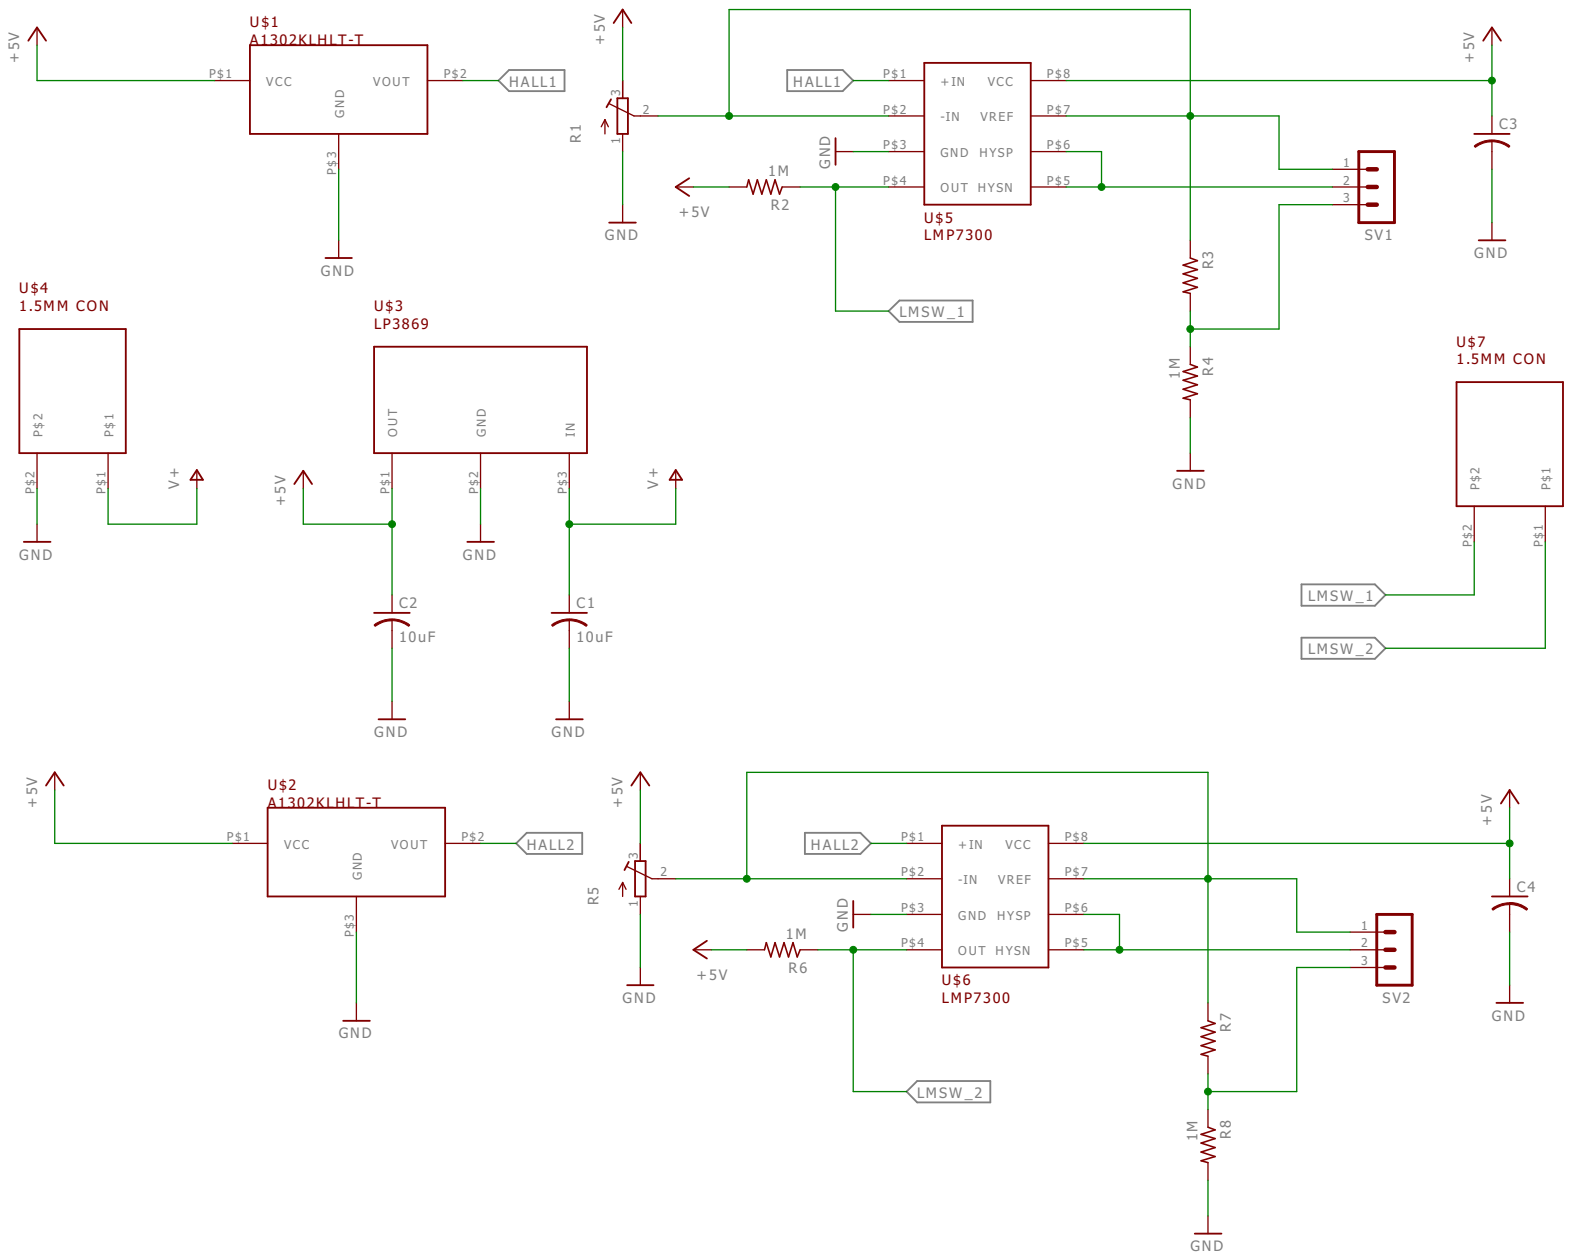
[picture p113: page 1]
