caiespin/Master_Tesis_2DOF_Gimbal_Model_and_Control/LaTex_Doc/img/SenalCont-eps-converted-to.pdf

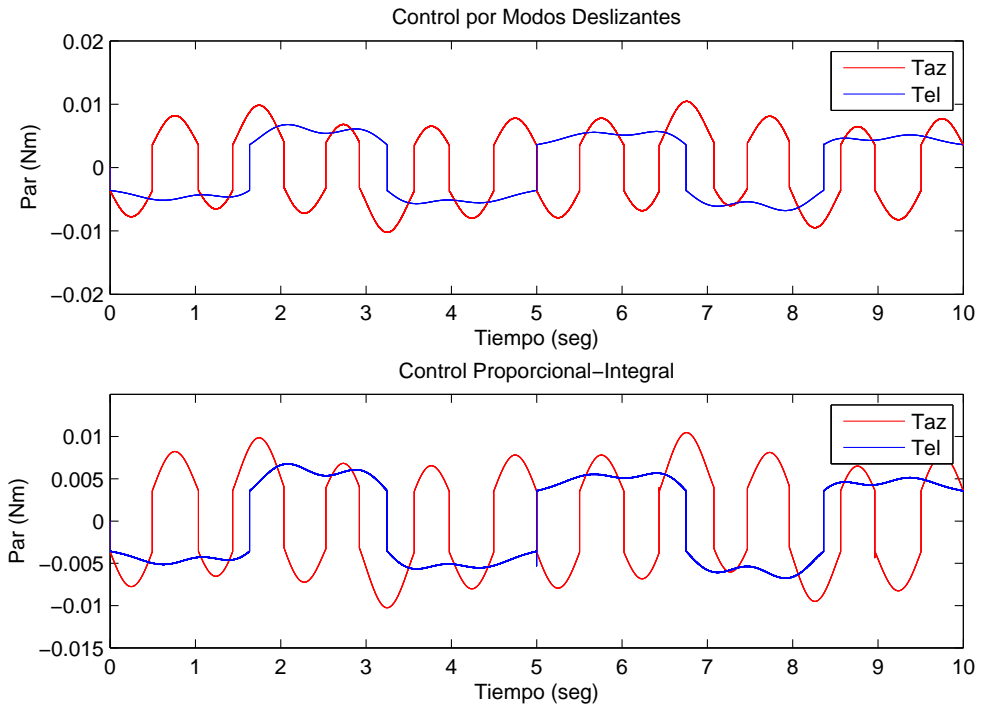
[picture p114: page 1]
Tiempo (seg); Par (Nm); Taz Tel

Control por Modos Deslizantes

Control Proporcional−Integral
