caiespin/Master_Tesis_2DOF_Gimbal_Model_and_Control/dsPIC_Implementation/Controles/ControlPI/ControlPI_Tilt/ControlPI_Tilt.X/src/rtGetInf.c

/*--------------------------------------------------------------
 *   MPLAB Blockset v3.35 for Microchip dsPIC chip family.     *
 *   Generate .c and .h files from Simulink model              *
 *   and compile to .elf, .hex and .cof file that can be       *
 *   flashed into the microcontroller                          *
 *                                                             *
 *      The Microchip name PIC, dsPIC, and MPLAB are           *
 *      registered trademarks of Microchip Technology Inc.     *
 *      MATLAB, Simulink, and Real-Time Workshop are           *
 *      registered trademarks of The MathWorks, Inc.           *
 *                                                             *
 *  Blockset authors: L.Kerhuel, U.Kumar                       *
 *  Product Page:  http://www.microchip.com/SimulinkBlocks     *
 *          Forum: http://www.microchip.com/forums/f192.aspx   *
 *          Wiki:  http://microchip.wikidot.com/simulink:start *
 *--------------------------------------------------------------
 *
 * File: rtGetInf.c
 *
 * Real-Time Workshop code generated for Simulink model ControlPI_Tilt.
 *
 * Model version                        : 1.71
 * Real-Time Workshop file version      : 8.5 (R2013b) 08-Aug-2013
 * Real-Time Workshop file generated on : Fri Jun 26 11:26:50 2015
 * TLC version                          : 8.5 (Aug  6 2013)
 * C source code generated on           : Fri Jun 26 11:26:50 2015
 */
/*
 * Abstract:
 *      Function to intialize non-finite, Inf
 */
#include "rtGetInf.h"
#define NumBitsPerChar                 8U

/*
 * Initialize rtInf needed by the generated code.
 * Inf is initialized as non-signaling. Assumes IEEE.
 */
real_T rtGetInf(void)
{
  size_t bitsPerReal = sizeof(real_T) * (NumBitsPerChar);
  real_T inf = 0.0;
  if (bitsPerReal == 32U) {
    inf = rtGetInfF();
  } else {
    union {
      LittleEndianIEEEDouble bitVal;
      real_T fltVal;
    } tmpVal;

    tmpVal.bitVal.words.wordH = 0x7FF00000U;
    tmpVal.bitVal.words.wordL = 0x00000000U;
    inf = tmpVal.fltVal;
  }

  return inf;
}

/*
 * Initialize rtInfF needed by the generated code.
 * Inf is initialized as non-signaling. Assumes IEEE.
 */
real32_T rtGetInfF(void)
{
  IEEESingle infF;
  infF.wordL.wordLuint = 0x7F800000U;
  return infF.wordL.wordLreal;
}

/*
 * Initialize rtMinusInf needed by the generated code.
 * Inf is initialized as non-signaling. Assumes IEEE.
 */
real_T rtGetMinusInf(void)
{
  size_t bitsPerReal = sizeof(real_T) * (NumBitsPerChar);
  real_T minf = 0.0;
  if (bitsPerReal == 32U) {
    minf = rtGetMinusInfF();
  } else {
    union {
      LittleEndianIEEEDouble bitVal;
      real_T fltVal;
    } tmpVal;

    tmpVal.bitVal.words.wordH = 0xFFF00000U;
    tmpVal.bitVal.words.wordL = 0x00000000U;
    minf = tmpVal.fltVal;
  }

  return minf;
}

/*
 * Initialize rtMinusInfF needed by the generated code.
 * Inf is initialized as non-signaling. Assumes IEEE.
 */
real32_T rtGetMinusInfF(void)
{
  IEEESingle minfF;
  minfF.wordL.wordLuint = 0xFF800000U;
  return minfF.wordL.wordLreal;
}

/* File trailer for Real-Time Workshop generated code.
 *
 * [EOF]
 */
